Tigertay0/robotics/blender/out/anim_30s.png

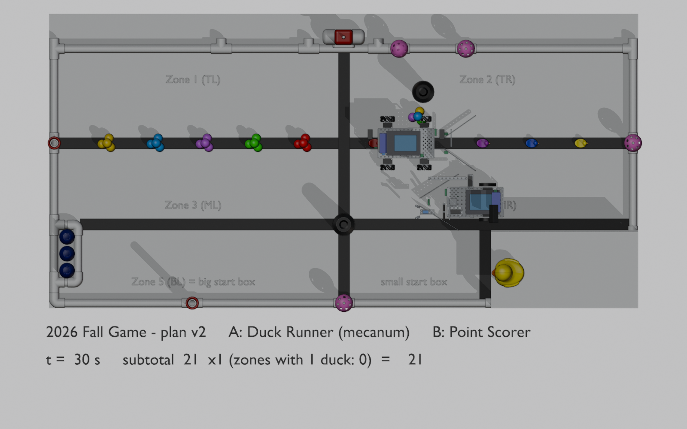
blender/out/anim_30s.png
