Tigertay0/robotics/blender/out/anim_57s.png

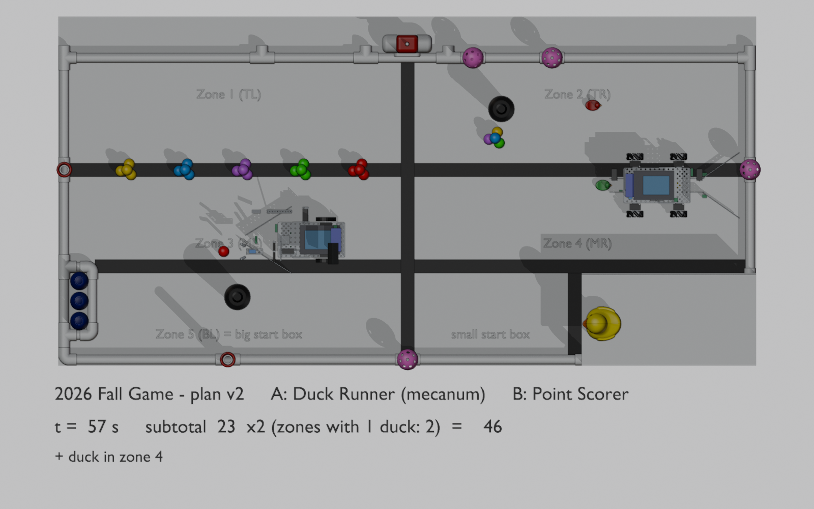
blender/out/anim_57s.png
