Tigertay0/robotics/blender/out/anim_76s.png

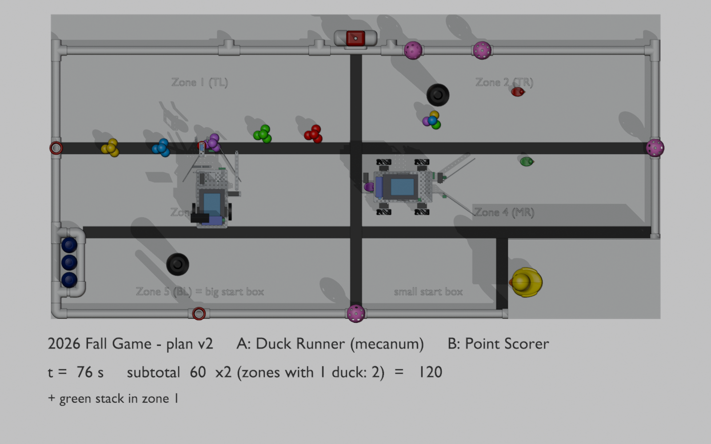
blender/out/anim_76s.png
