Tigertay0/robotics/blender/out/anim_110s.png

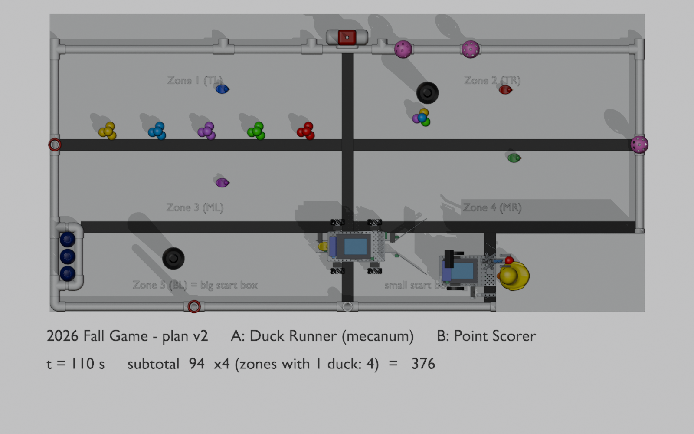
blender/out/anim_110s.png
