Tigertay0/robotics/blender/out/field_iso.png

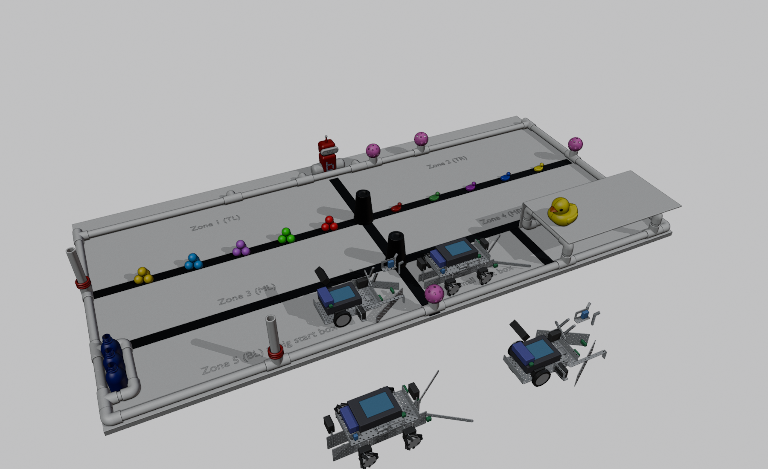
blender/out/field_iso.png
