Tigertay0/robotics/blender/out/field_top.png

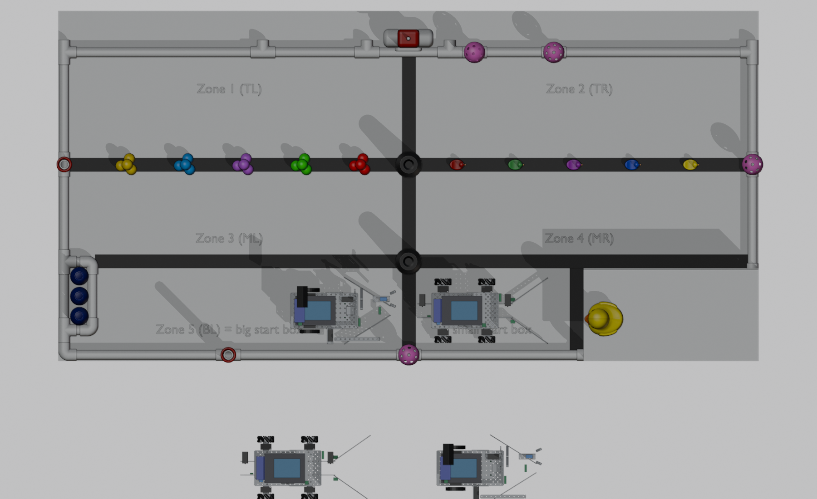
blender/out/field_top.png
