Tigertay0/robotics/blender/out/robot_A.png

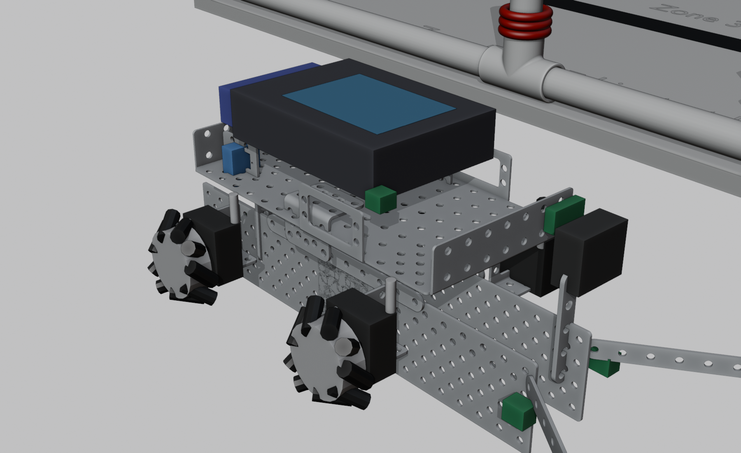
blender/out/robot_A.png
