Tigertay0/robotics/blender/out/robot_A_low.png

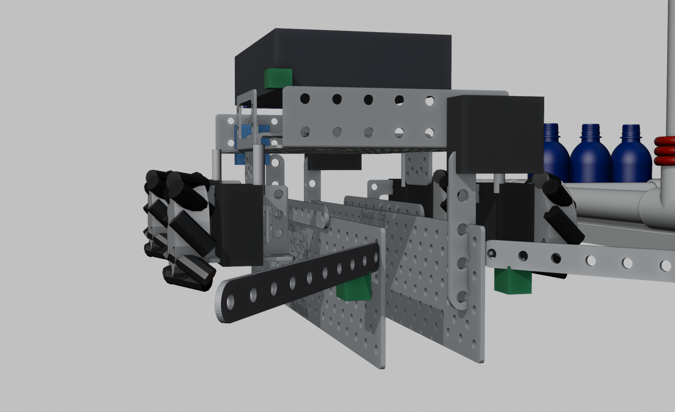
blender/out/robot_A_low.png
