Tigertay0/robotics/blender/out/robot_B.png

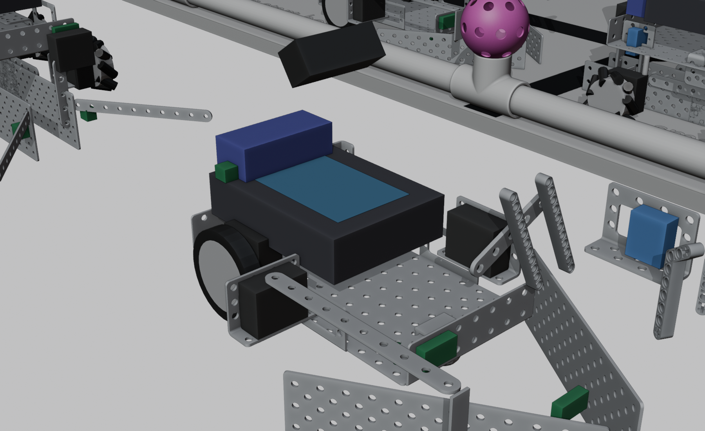
blender/out/robot_B.png
