Tigertay0/robotics/blender/out/start_box.png

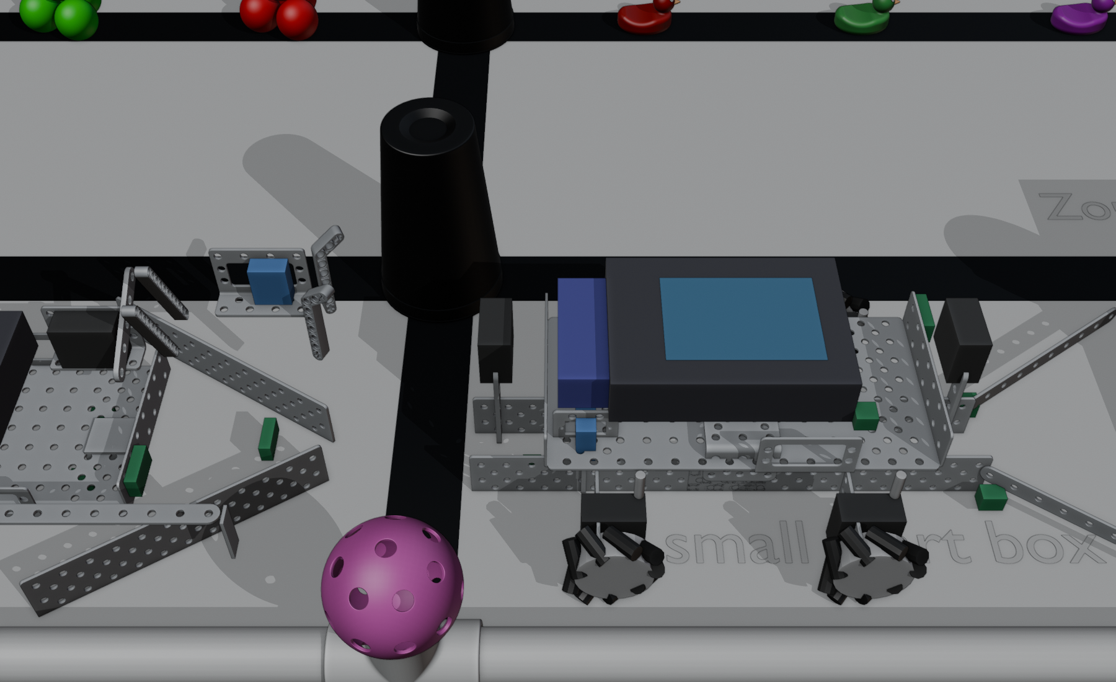
blender/out/start_box.png
