Tigertay0/robotics/docs/official/Fall_Game_Table_Overhead.png

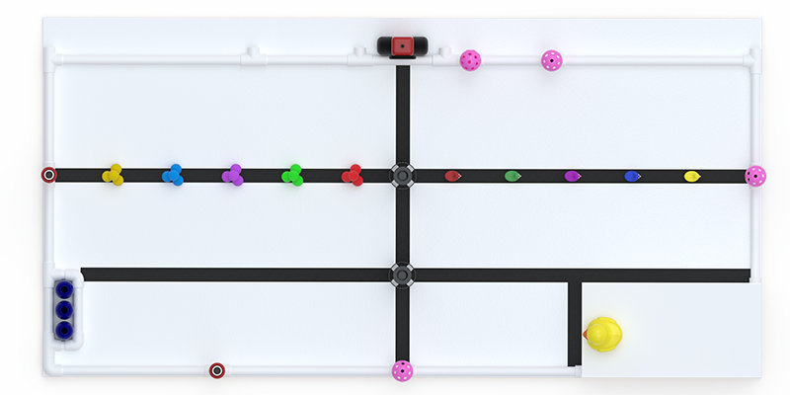
docs/official/Fall_Game_Table_Overhead.png
