Tigertay0/robotics/docs/official/Fall_Game_Zones.jpeg

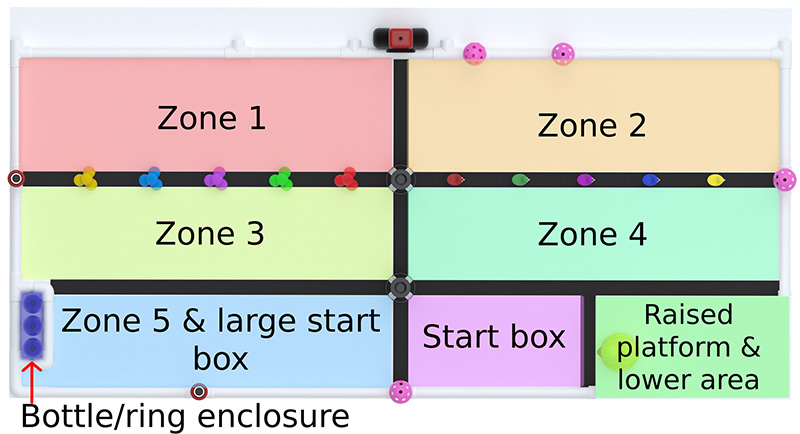
docs/official/Fall_Game_Zones.jpeg
