Tigertay0/robotics/docs/renders/iso.png

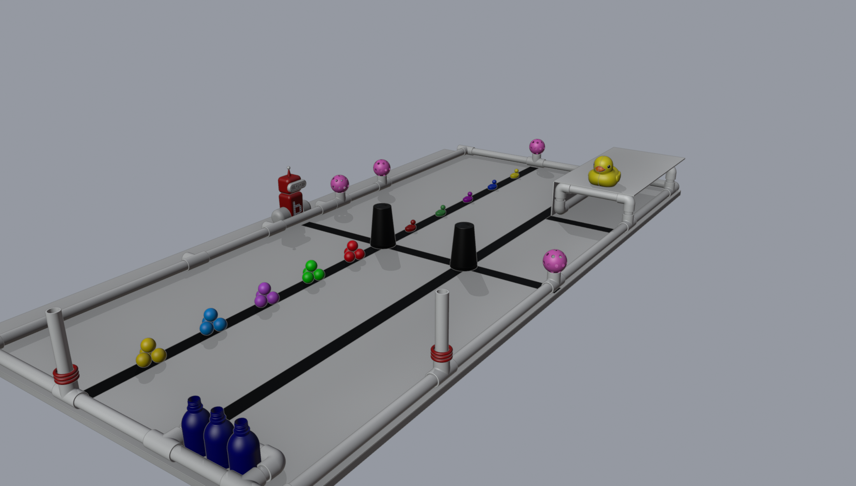
docs/renders/iso.png
