Tigertay0/robotics/docs/renders/platform_front.png

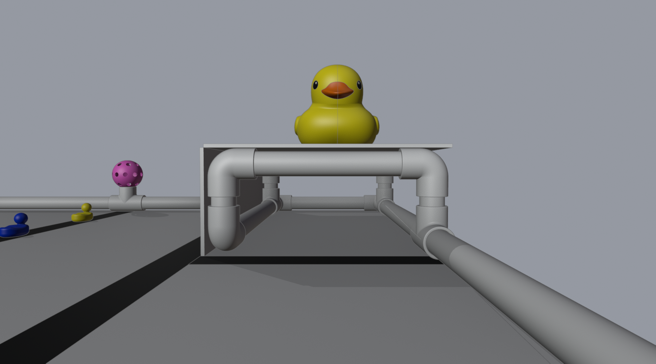
docs/renders/platform_front.png
