Tigertay0/robotics/docs/renders/top_ortho.png

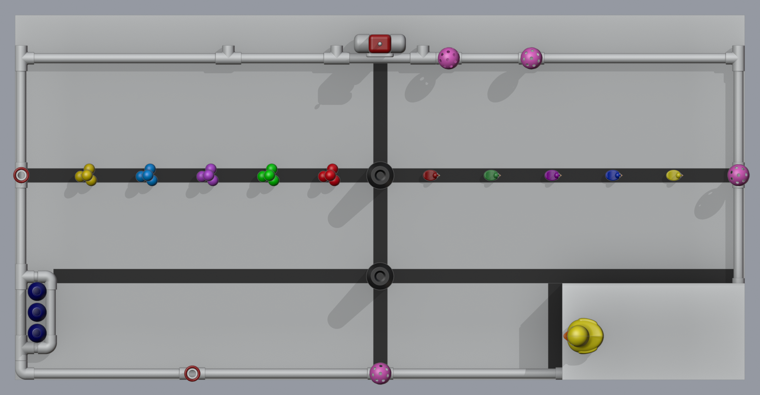
docs/renders/top_ortho.png
