Tigertay0/robotics/parts/team4/p1_chassis_a_top.png

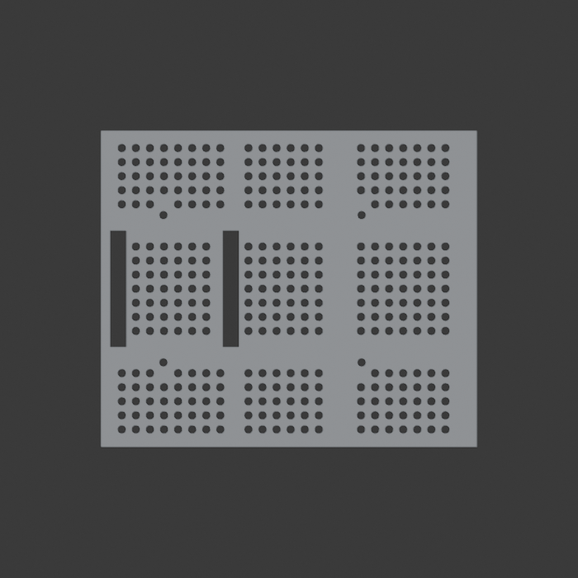
parts/team4/p1_chassis_a_top.png
