Tigertay0/robotics/parts/team4/budget.md

# Print budget check (generated by tools/blender/build_parts.py)

| Slot | Part | Robot | Copies | Class | Size mm | Whole-inch box | Min margin mm | Plastic cm3 | Checks |
|---|---|---|---:|---|---|---|---:|---:|---|
| 1/4 | `p1_chassis_a` | A | 1 | team | 214 x 180 x 59 | 9 x 8 x 3 | 6.0 | 353.68 | pass |
| 2/4 | `p2_claw_jaw` | B | 1 | team | 74 x 105 x 22 | 3 x 5 x 1 | 114.7 | 30.74 | pass |
| 3/4 | `p3_pocket_plow` | B | 1 | team | 108 x 206 x 72 | 5 x 9 x 3 | 13.9 | 107.39 | pass |
| 4/4 | `p4_cup_hook` | B | 1 | team | 157 x 14 x 62 | 7 x 1 x 3 | 63.0 | 20.04 | pass |

Checks = manifold, expected number of bodies, positive volume, fits the size box in mm as exported, >= 1 mm margin. Team rule: 4 parts total, each within 220 x 220 x 250 mm; each print is one solid piece.

Budget used: 4/4 team

Problems: none
