Tigertay0/robotics/docs/manual/bom.md

# Bill of materials vs the 2026 kit (generated by tools/blender/export_build_manual.py)

| Part | Robot A | Robot B | Total | In kit | OK |
|---|---:|---:|---:|---:|---|
| Claw jaw (print 2) | 0 | 1 | 1 | print | yes |
| Cup hook (print 4) | 0 | 1 | 1 | print | yes |
| Pocket plow (print 3) | 0 | 1 | 1 | print | yes |
| Printed chassis (print 1) | 1 | 0 | 1 | print | yes |
| 1 x 11 Liftarm | 0 | 2 | 2 | 10 | yes |
| 1 x 3 Liftarm | 0 | 1 | 1 | 16 | yes |
| 1 x 5 Liftarm | 0 | 1 | 1 | 11 | yes |
| 1 x 5 Servo Horn | 2 | 1 | 3 | 4 | yes |
| 1 x 7 Liftarm | 3 | 1 | 4 | 16 | yes |
| 2-56 1" Caster Screw | 0 | 2 | 2 | 5 | yes |
| 2-56 3/8" Micro Servo Mount Screw | 2 | 0 | 2 | 6 | yes |
| Angle Bracket | 0 | 1 | 1 | 2 | yes |
| Black Camera | 0 | 1 | 1 | 1 | yes |
| Black Gear Motor | 4 | 2 | 6 | 8 | yes |
| Brass Screws | 2 | 2 | 4 | 10 | yes |
| Caster | 0 | 1 | 1 | 2 | yes |
| Channel 3 x 8 | 0 | 1 | 1 | 3 | yes |
| Chassis | 0 | 1 | 1 | 2 | yes |
| ET (Rangefinder) | 1 | 1 | 2 | 2 | yes |
| Lever | 0 | 1 | 1 | 2 | yes |
| Light | 1 | 1 | 2 | 3 | yes |
| M3 x 0.5" x 6" Mecanum Wheel Screw | 4 | 0 | 4 | 6 | yes |
| Mecanum Wheel | 4 | 0 | 4 | 4 | yes |
| Micro Servo | 1 | 0 | 1 | 2 | yes |
| Micro Servo Mount | 1 | 0 | 1 | 2 | yes |
| Nut 8-32 Keps (black) | 49 | 42 | 91 | 170 | yes |
| Pin w/ Friction | 0 | 3 | 3 | 122 | yes |
| Plate 4 x 12 | 2 | 0 | 2 | 4 | yes |
| Round Servo Horn | 0 | 2 | 2 | 2 | yes |
| Screw 8-32 x 1/2" (black) | 45 | 35 | 80 | 90 | yes |
| Screw 8-32 x 1/4" (black) | 12 | 14 | 26 | 40 | yes |
| Screw 8-32 x 3/4" (black) | 0 | 1 | 1 | 70 | yes |
| Servo | 2 | 3 | 5 | 5 | yes |
| Servo Bracket | 2 | 5 | 7 | 8 | yes |
| Short Silver Servo Horn Screw (M3) | 2 | 2 | 4 | 6 | yes |
| Silver Servo Horn Machine Screw (M3) | 0 | 7 | 7 | 10 | yes |
| Silver Servo Horn Nut (M3) | 0 | 6 | 6 | 10 | yes |
| Small Touch | 1 | 0 | 1 | 4 | yes |
| Solarbotics Wheel | 0 | 2 | 2 | 4 | yes |
| Standoff 8-32 x 1" | 4 | 0 | 4 | 7 | yes |
| Standoff 8-32 x 1/2" | 0 | 4 | 4 | 12 | yes |
| Standoff 8-32 x 2" | 2 | 0 | 2 | 2 | yes |
| Strap 1 x 10 | 3 | 0 | 3 | 6 | yes |
| Threaded Rod 8-32 x 1" | 2 | 0 | 2 | 10 | yes |
| Tophat (Reflectance) | 2 | 2 | 4 | 4 | yes |
| Wombat | 1 | 1 | 2 | 2 | yes |
| Wombat Battery | 1 | 1 | 2 | 2 | yes |
| Zip tie 4" (white), structural | 2 | 2 | 4 | 5 | yes |

Printed parts: 4/4

## Size check (start-box limit 11.25 x 21.125 x 12 in = 285.8 x 536.6 x 304.8 mm)

| Robot | Width mm | Length mm | Height mm | Fits |
|---|---:|---:|---:|---|
| A | 271.3 | 400.0 | 160.8 | yes |
| B | 206.1 | 388.1 | 161.6 | yes |

Problems: none
