Tigertay0/robotics/docs/2026 KIPR Metal Parts.pdf

Description | Picture | # in 2026 Kit | Bendable
Strap 1 x 19 | 4 | Yes
Strap 1 x 10 | 6 | Yes
Channel 3 x 8 | 3 | No
Channel 3 x 12 | 2 | No
Channel 3 x 16 | 1 | No
Plate 4 x 12 | 4 | Yes
Chassis | 2 | No

## KIPR Metal

D Bracket | 1 | No
Angle Bracket | 2 | No

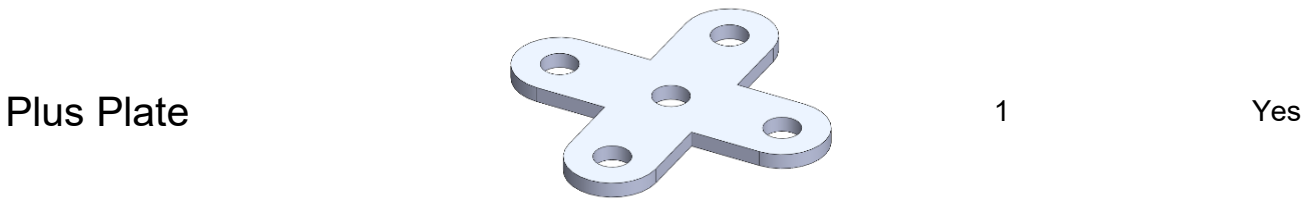
[picture p28: figure]
Plus Plate; Yes

Servo Bracket | 8 | No
Round Servo Horn | 2 | No
1 x 5 Servo Horn | 4 | No

Screw 8-32 x 1/4" (black) | 40
Screw 8-32 x 1/2" (black) | 90
Screw 8-32 x 3/4" (black) | 70
Nut 8-32 Keps (black) | 170
Nut 8-32 Nylock (black) | 30
Standoff 8-32 x 1/2" | 12
Standoff 8-32 x 1" | 7
Standoff 8-32 x 2" | 2

## Screws, Nuts, and Standoffs

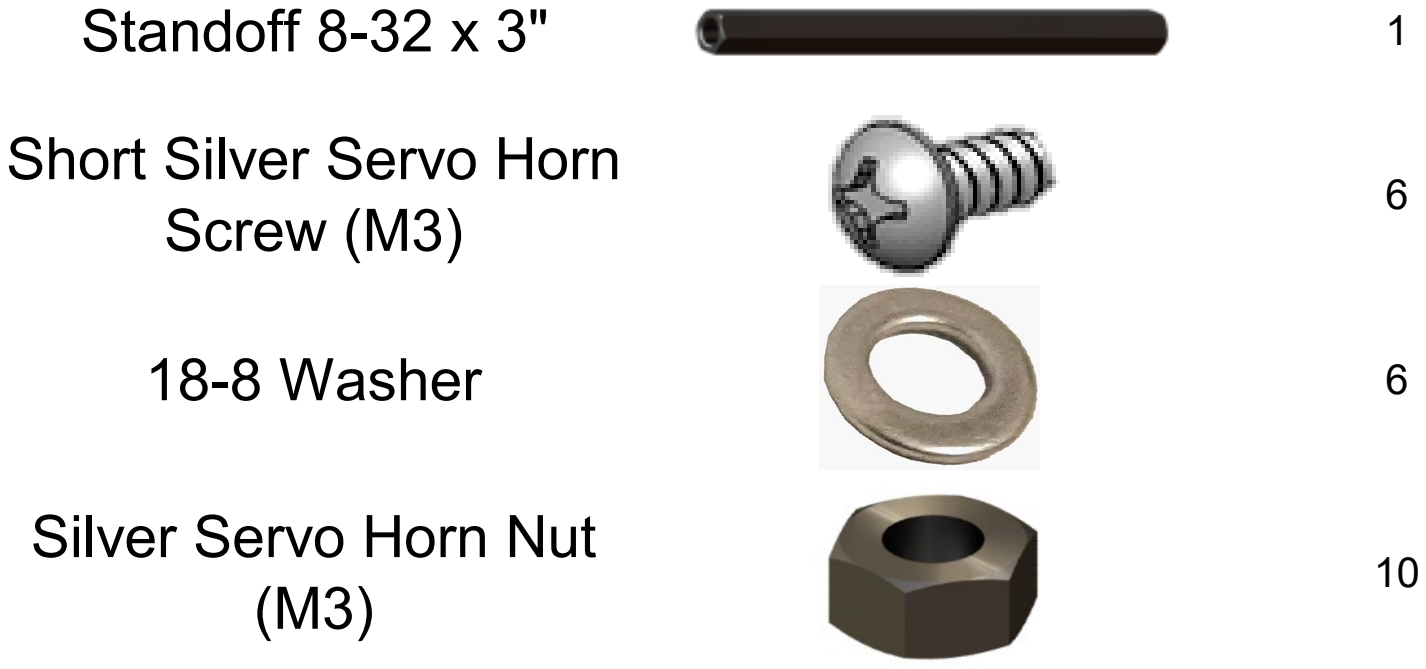
[picture p29: figure]
Standoff 8-32 x 3"; Short Silver Servo Horn; Screw (M3); 18-8 Washer; Silver Servo Horn Nut

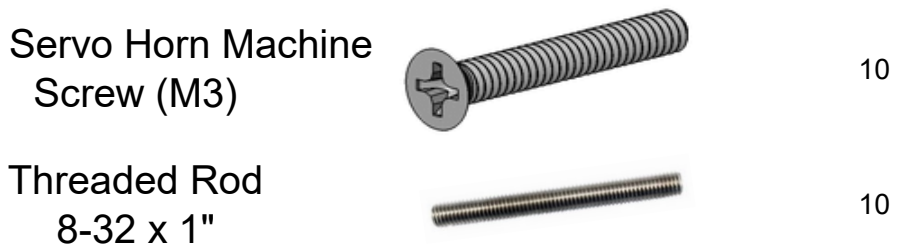
[picture p30: figure]
Screw (M3); Threaded Rod

Silver Servo Horn Machine

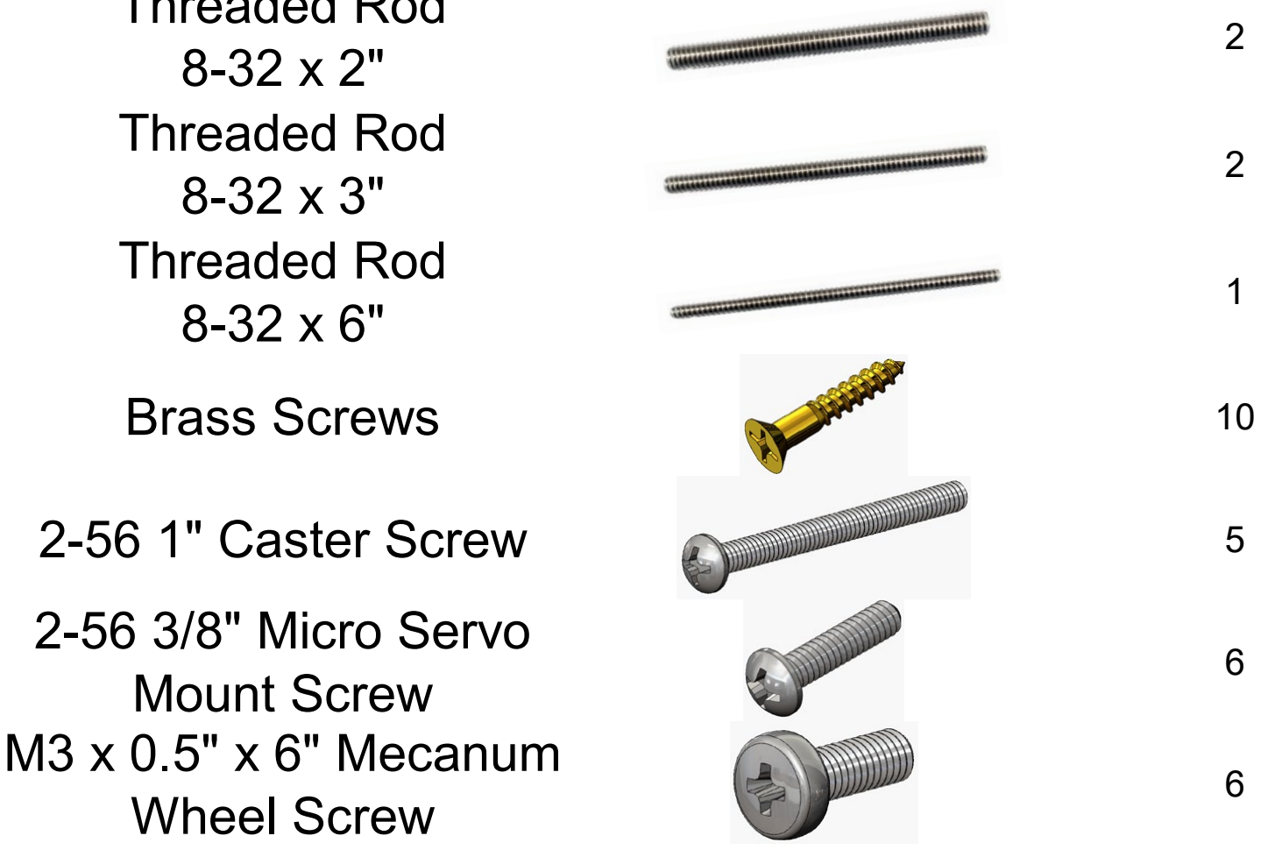
[picture p31: figure]
Threaded Rod; Brass Screws; 2-56 1" Caster Screw; 2-56 3/8" Micro Servo; Mount Screw; M3 x 0.5" x 6" Mecanum; Wheel Screw

Threaded Rod

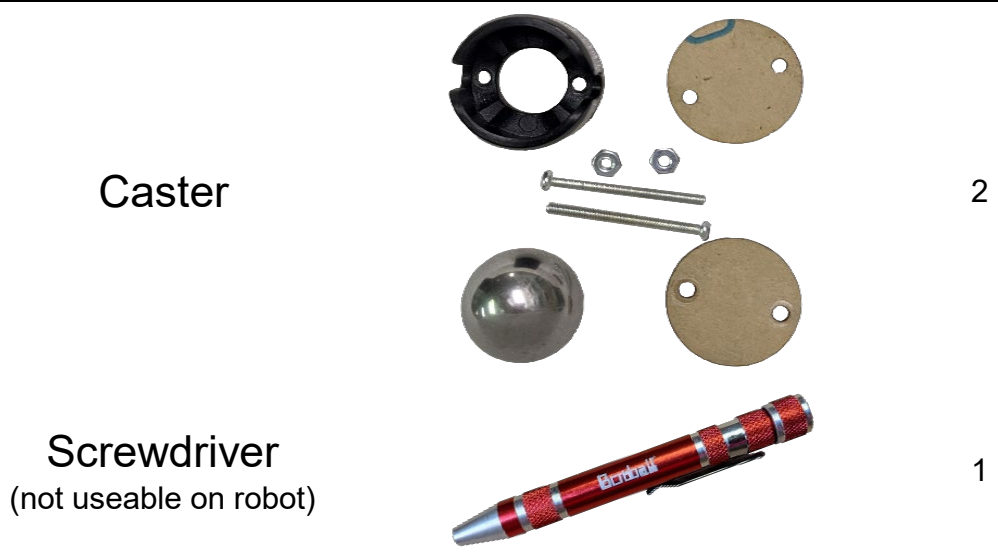
[picture p32: figure]
Caster; Screwdriver (not useable on robot)

11/32" Wrench
(not useable on robot)

1

MISC.
