Tigertay0/robotics/Botball_Fall_Seeding_Scoresheet.xlsx

Theme Budget: $0
A game so good, we forgot the theme.
Team Name: |  |  | Team #:
Round:
Area | Item | Count | Pts Each | Subtotal
1. Base Score | Objects touching board, off black tape | 0 | 1 | 0
2. Pickleballs | Under raised platform | 0 | 7 | 0
3. Rings | Touching bottle, not on neck | 0 | 3 | 0
3. Rings | On bottle neck (volume broken) | 0 | 15 | 0
4. Ducks | Under raised platform | 0 | 3 | 0
5. Cups | Nested in other cup (1=Yes, 0=No) | 0 | 20 | 0
5. Cups | Flat/upright on base each cup (0-2) | 0 | 20 | 0
6. Botguy | On top of raised platform (1=Yes, 0=No) | 0 | 15 | 0
7. Big Duck | At Botguy's starting position (1=Yes, 0=No) | 0 | 15 | 0
8. Mystery Red Pom | Isolated alone on platform (1=Yes, 0=No) | 0 | 50 | 0
9. Pom Zones
Zone (placeholder) | Same-Color Count (0-5) | Unique-Color Count (0-5) |  | Bonus
Zone 1 | 0 | 0 |  | 0
Zone 2 | 0 | 0 |  | 0
Zone 3 | 0 | 0 |  | 0
Zone 4 | 0 | 0 |  | 0
Zone 5 | 0 | 0 |  | 0
Round Subtotal (Areas 1–9) |  |  |  | 0
Overall Multiplier — Zones with Exactly 1 Smaller Duck
Zone | Exactly 1 Duck? (1=Yes, 0=No)
Zone 1 | 0
Zone 2 | 0
Zone 3 | 0
Zone 4 | 0
Zone 5 | 0
Qualifying Zone Count | 0
Multiplier (min 1x, max 5x) | 1
TOTAL SCORE |  |  |  | 0
Legend:
Yellow cells = judge fills in during scoring
Blue text = fixed point value (game constant)
Black text = calculated automatically
