Tigertay0/robotics/parts/team4/p2_claw_jaw_top.png

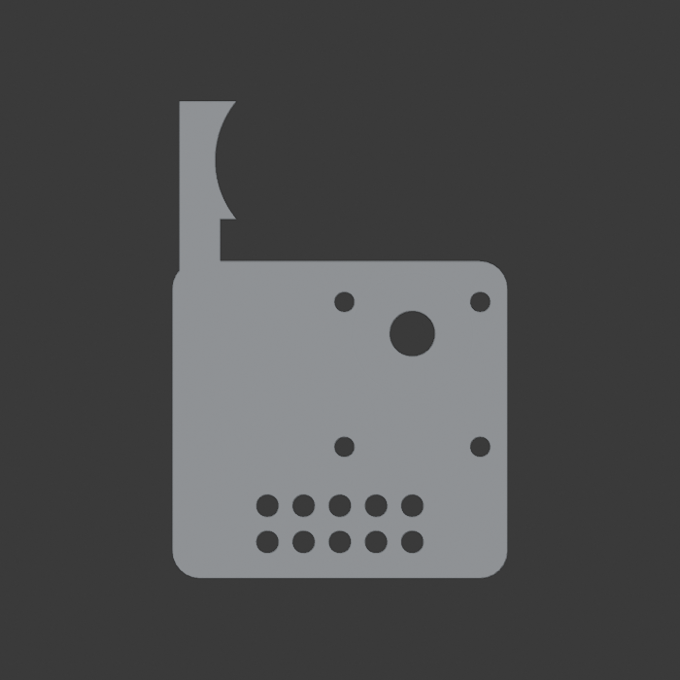
parts/team4/p2_claw_jaw_top.png
