Tigertay0/robotics/parts/team4/p2_claw_jaw_under.png

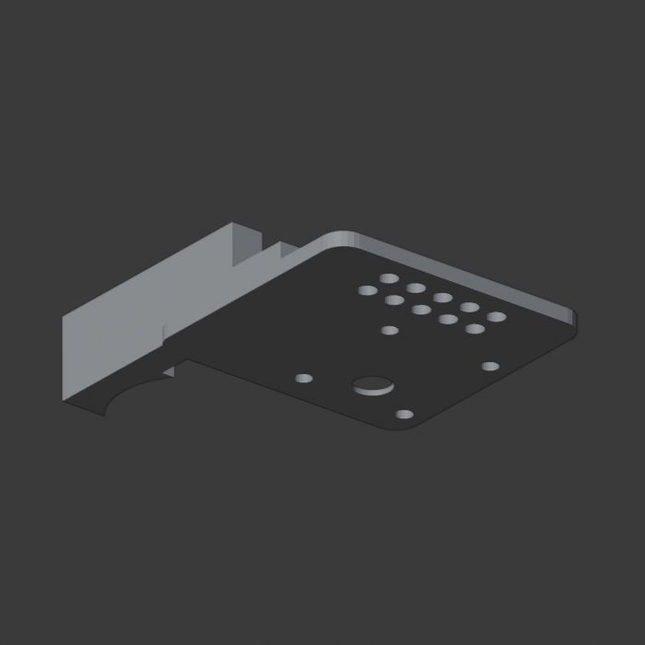
parts/team4/p2_claw_jaw_under.png
