Tigertay0/robotics/parts/team4/p3_pocket_plow.png

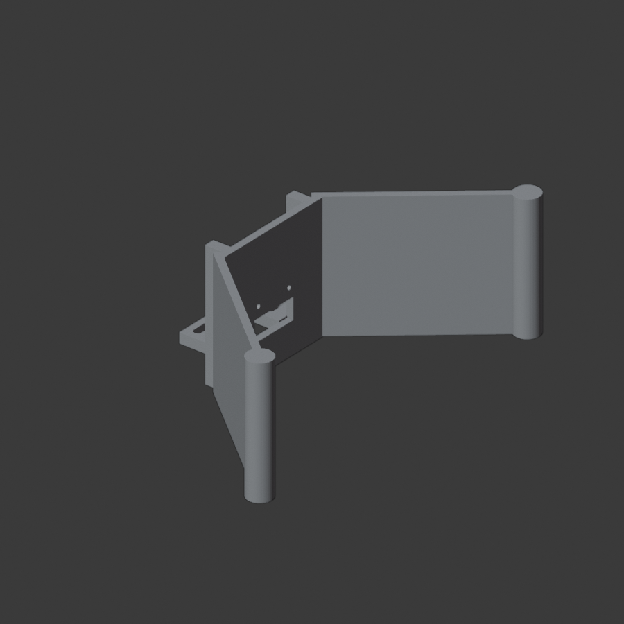
parts/team4/p3_pocket_plow.png
