Tigertay0/robotics/parts/team4/p3_pocket_plow_top.png

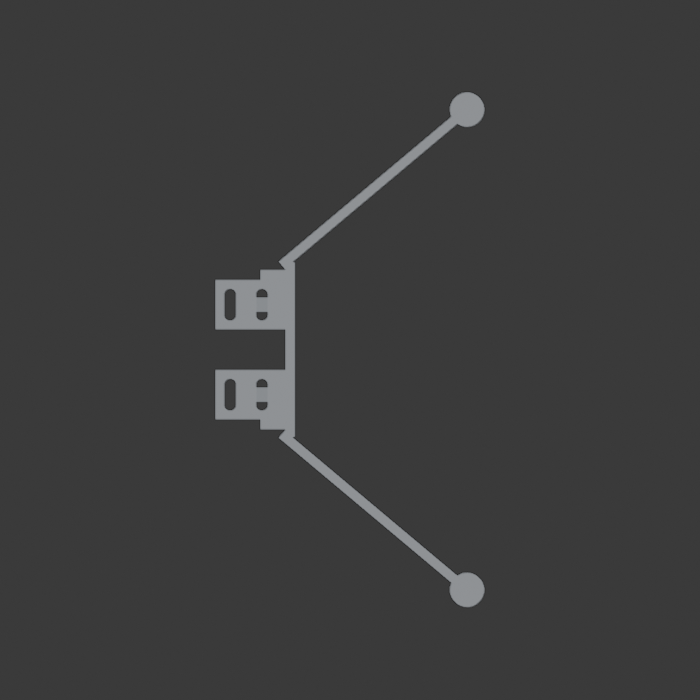
parts/team4/p3_pocket_plow_top.png
