Tigertay0/robotics/parts/team4/p4_cup_hook_top.png

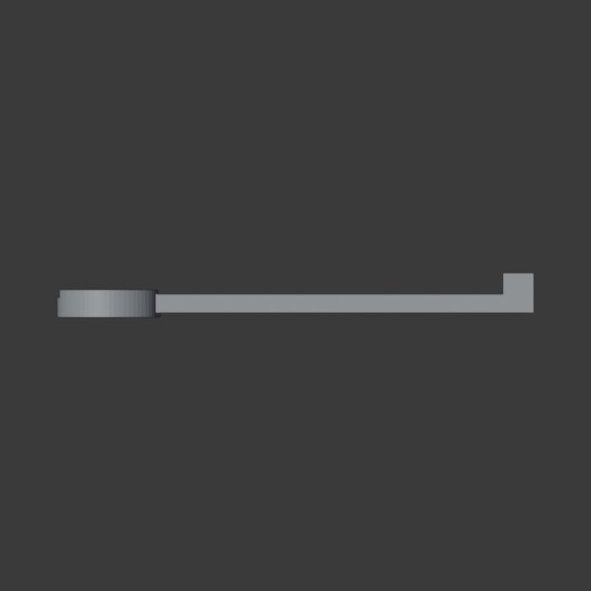
parts/team4/p4_cup_hook_top.png
