Tigertay0/robotics/docs/manual/robot_a.obj

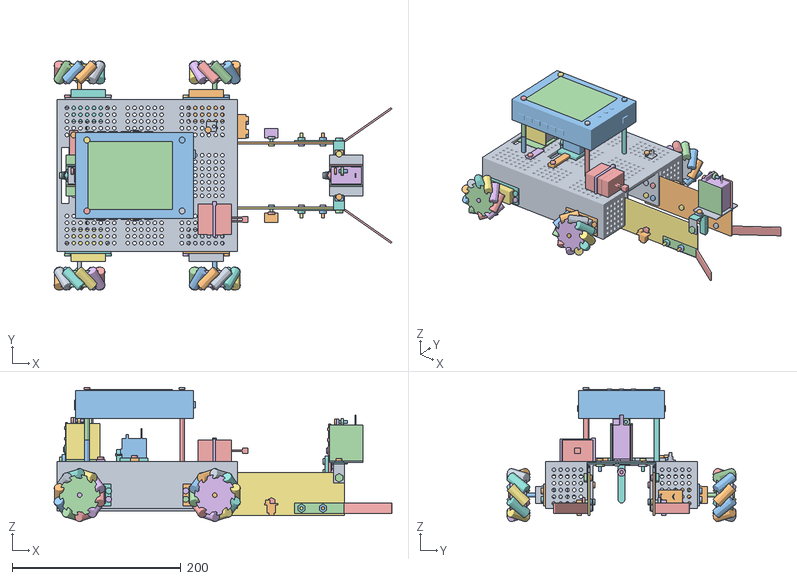
[picture p41: CAD file, 2026-11-10]
docs/manual/robot_a.obj
400.0 x 271.3 x 159.2
01.1|Printed_chassis_(print_1)
02.1|Black_Gear_Motor
02.1|Black_Gear_Motor_(ear)
02.1|Black_Gear_Motor_(shaft)
02.2|Screw_8-32_x_1/2"_(black)
02.2|Screw_8-32_x_1/2"_(black)_(shank)
02.2|Screw_8-32_x_1/2"_(black).001
02.2|Screw_8-32_x_1/2"_(black)_(shank).001
02.2|Screw_8-32_x_1/2"_(black).002
02.2|Screw_8-32_x_1/2"_(black)_(shank).002
02.2|Screw_8-32_x_1/2"_(black).003
02.2|Screw_8-32_x_1/2"_(black)_(shank).003
02.3|Nut_8-32_Keps_(black)
02.3|Nut_8-32_Keps_(black).001
02.3|Nut_8-32_Keps_(black).002
02.3|Nut_8-32_Keps_(black).003
02.4|Black_Gear_Motor
02.4|Black_Gear_Motor_(ear)
02.4|Black_Gear_Motor_(shaft)
02.4|Screw_8-32_x_1/2"_(black)
02.4|Screw_8-32_x_1/2"_(black)_(shank)
02.4|Screw_8-32_x_1/2"_(black).001
02.4|Screw_8-32_x_1/2"_(black)_(shank).001
02.4|Screw_8-32_x_1/2"_(black).002
02.4|Screw_8-32_x_1/2"_(black)_(shank).002
02.4|Screw_8-32_x_1/2"_(black).003
02.4|Screw_8-32_x_1/2"_(black)_(shank).003
02.4|Nut_8-32_Keps_(black)
02.4|Nut_8-32_Keps_(black).001
02.4|Nut_8-32_Keps_(black).002
02.4|Nut_8-32_Keps_(black).003
02.4|Black_Gear_Motor.001
02.4|Black_Gear_Motor_(ear).001
02.4|Black_Gear_Motor_(shaft).001
02.4|Screw_8-32_x_1/2"_(black).004
02.4|Screw_8-32_x_1/2"_(black)_(shank).004
02.4|Screw_8-32_x_1/2"_(black).005
02.4|Screw_8-32_x_1/2"_(black)_(shank).005
02.4|Screw_8-32_x_1/2"_(black).006
02.4|Screw_8-32_x_1/2"_(black)_(shank).006
02.4|Screw_8-32_x_1/2"_(black).007
02.4|Screw_8-32_x_1/2"_(black)_(shank).007
02.4|Nut_8-32_Keps_(black).004
02.4|Nut_8-32_Keps_(black).005
02.4|Nut_8-32_Keps_(black).006
02.4|Nut_8-32_Keps_(black).007
02.4|Black_Gear_Motor.002
02.4|Black_Gear_Motor_(ear).002
02.4|Black_Gear_Motor_(shaft).002
02.4|Screw_8-32_x_1/2"_(black).008
02.4|Screw_8-32_x_1/2"_(black)_(shank).008
02.4|Screw_8-32_x_1/2"_(black).009
02.4|Screw_8-32_x_1/2"_(black)_(shank).009
02.4|Screw_8-32_x_1/2"_(black).010
02.4|Screw_8-32_x_1/2"_(black)_(shank).010
02.4|Screw_8-32_x_1/2"_(black).011
02.4|Screw_8-32_x_1/2"_(black)_(shank).011
02.4|Nut_8-32_Keps_(black).008
02.4|Nut_8-32_Keps_(black).009
02.4|Nut_8-32_Keps_(black).010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
