Tigertay0/robotics/parts/team4/p2_claw_jaw.stl

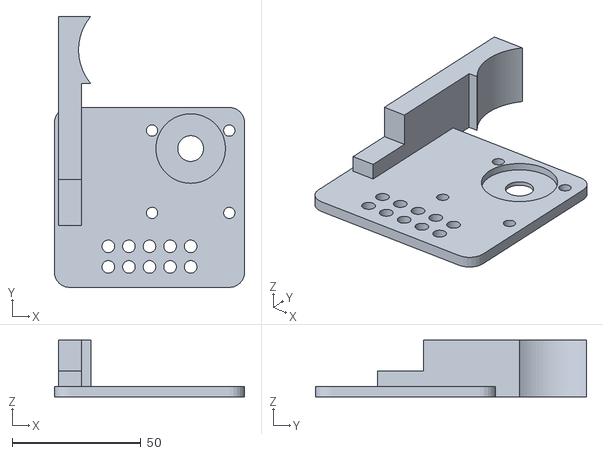
[picture p42: CAD file, 2026-11-10]
parts/team4/p2_claw_jaw.stl
74.0 x 105.3 x 22.0
