Tigertay0/robotics/prints/out/lane_front.stl

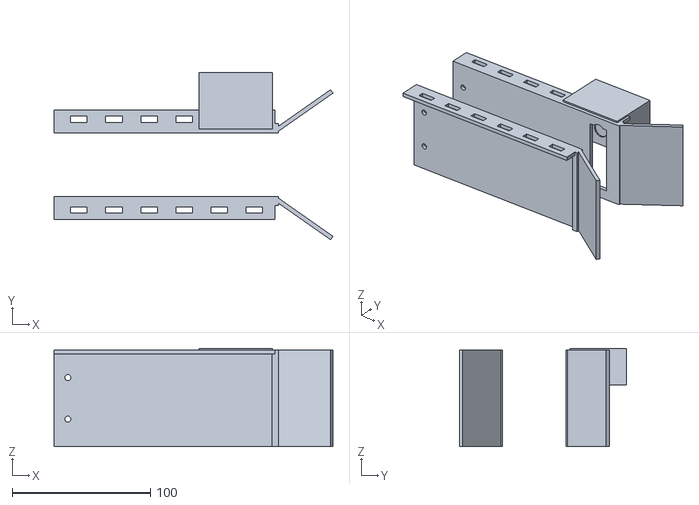
[picture p43: CAD file, 2026-10-21]
prints/out/lane_front.stl
201.8 x 121.1 x 71.2
