Tigertay0/robotics/docs/manual/robot_b.obj

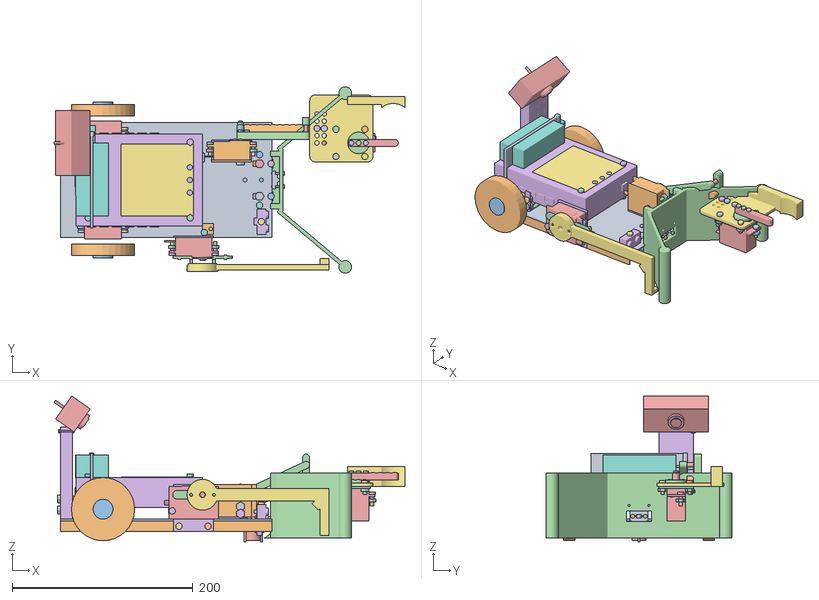
[picture p44: CAD file, 2026-11-10]
docs/manual/robot_b.obj
388.1 x 206.1 x 161.4
01.1|Chassis
01.1|Chassis_(flange)
01.1|Chassis_(flange).001
02.1|Servo_Bracket
02.1|Servo_Bracket.001
02.1|Servo_Bracket.002
02.1|Screw_8-32_x_1/4"_(black)
02.1|Screw_8-32_x_1/4"_(black)_(shank)
02.1|Nut_8-32_Keps_(black)
02.1|Screw_8-32_x_1/4"_(black).001
02.1|Screw_8-32_x_1/4"_(black)_(shank).001
02.1|Nut_8-32_Keps_(black).001
02.2|Black_Gear_Motor
02.3|Screw_8-32_x_1/2"_(black)
02.3|Screw_8-32_x_1/2"_(black)_(shank)
02.3|Nut_8-32_Keps_(black)
02.3|Screw_8-32_x_1/2"_(black).001
02.3|Screw_8-32_x_1/2"_(black)_(shank).001
02.3|Nut_8-32_Keps_(black).001
02.3|Screw_8-32_x_1/2"_(black).002
02.3|Screw_8-32_x_1/2"_(black)_(shank).002
02.3|Nut_8-32_Keps_(black).002
02.3|Screw_8-32_x_1/2"_(black).003
02.3|Screw_8-32_x_1/2"_(black)_(shank).003
02.3|Nut_8-32_Keps_(black).003
02.4|Solarbotics_Wheel
02.4|Solarbotics_Wheel_(hub)
02.5|Servo_Bracket
02.5|Servo_Bracket.001
02.5|Servo_Bracket.002
02.5|Screw_8-32_x_1/4"_(black)
02.5|Screw_8-32_x_1/4"_(black)_(shank)
02.5|Nut_8-32_Keps_(black)
02.5|Screw_8-32_x_1/4"_(black).001
02.5|Screw_8-32_x_1/4"_(black)_(shank).001
02.5|Nut_8-32_Keps_(black).001
02.5|Black_Gear_Motor
02.5|Screw_8-32_x_1/2"_(black)
02.5|Screw_8-32_x_1/2"_(black)_(shank)
02.5|Nut_8-32_Keps_(black).002
02.5|Screw_8-32_x_1/2"_(black).001
02.5|Screw_8-32_x_1/2"_(black)_(shank).001
02.5|Nut_8-32_Keps_(black).003
02.5|Screw_8-32_x_1/2"_(black).002
02.5|Screw_8-32_x_1/2"_(black)_(shank).002
02.5|Nut_8-32_Keps_(black).004
02.5|Screw_8-32_x_1/2"_(black).003
02.5|Screw_8-32_x_1/2"_(black)_(shank).003
02.5|Nut_8-32_Keps_(black).005
02.5|Solarbotics_Wheel
02.5|Solarbotics_Wheel_(hub)
02.6|Caster
02.6|Caster_(ball)
02.6|2-56_1"_Caster_Screw
02.6|2-56_1"_Caster_Screw_(shank)
02.6|2-56_1"_Caster_Screw.001
02.6|2-56_1"_Caster_Screw_(shank).001
03.1|Standoff_8-32_x_1/2"
03.1|Screw_8-32_x_1/4"_(black)
03.1|Screw_8-32_x_1/4"_(black)_(shank)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
