Tigertay0/robotics/parts/team4/p1_chassis_a.stl

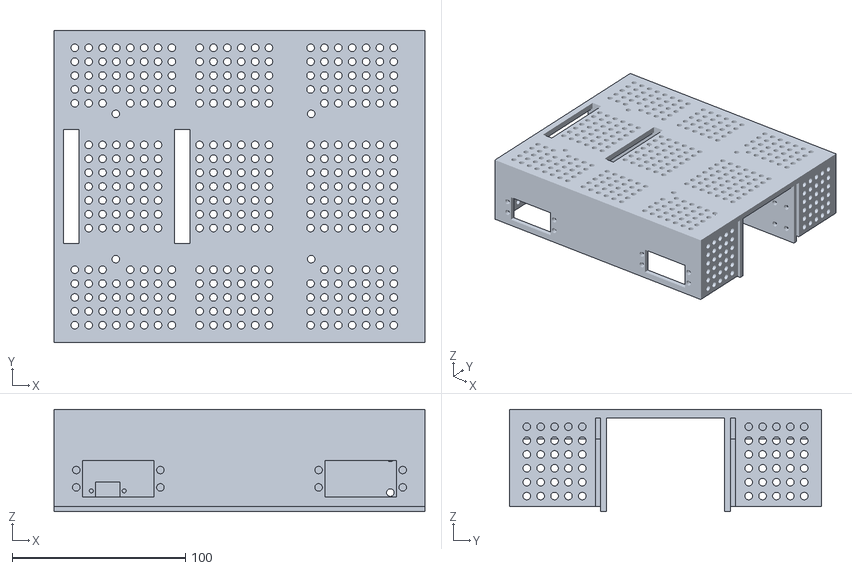
[picture p45: CAD file, 2026-11-10]
parts/team4/p1_chassis_a.stl
214.0 x 180.0 x 59.0
