Tigertay0/robotics/prints/out/lane_rear.stl

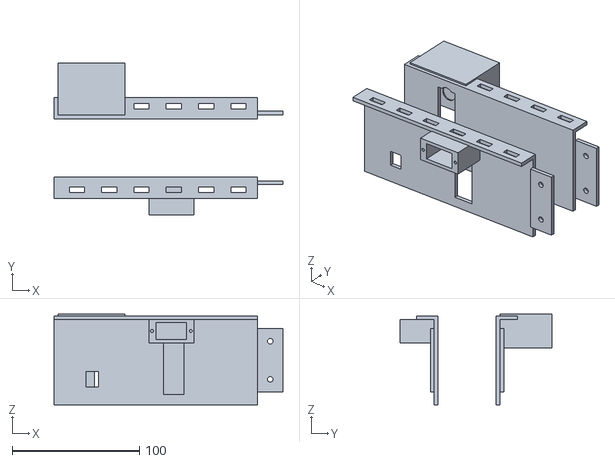
[picture p46: CAD file, 2026-10-21]
prints/out/lane_rear.stl
180.0 x 119.7 x 71.2
