Tigertay0/robotics/parts/team4/p4_cup_hook.stl

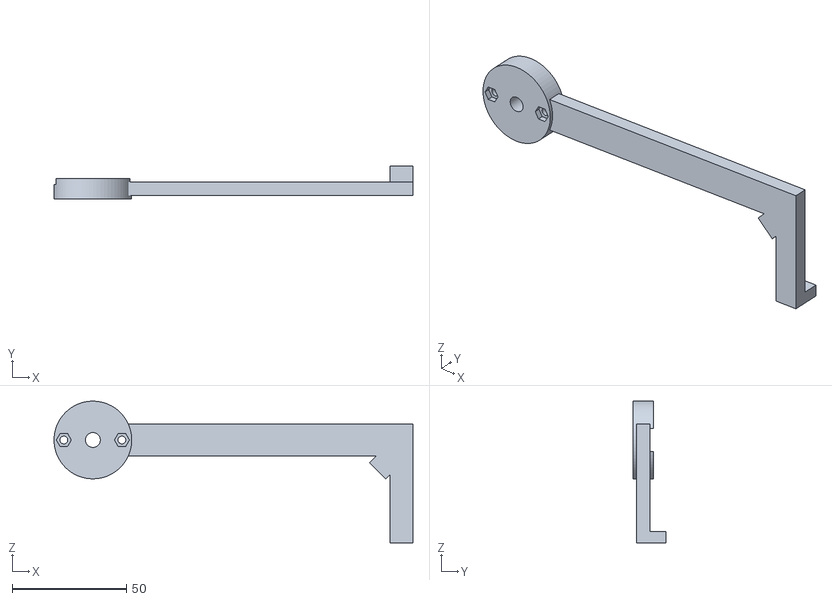
[picture p47: CAD file, 2026-11-10]
parts/team4/p4_cup_hook.stl
157.0 x 14.5 x 62.0
