Tigertay0/robotics/parts/team4/p3_pocket_plow.stl

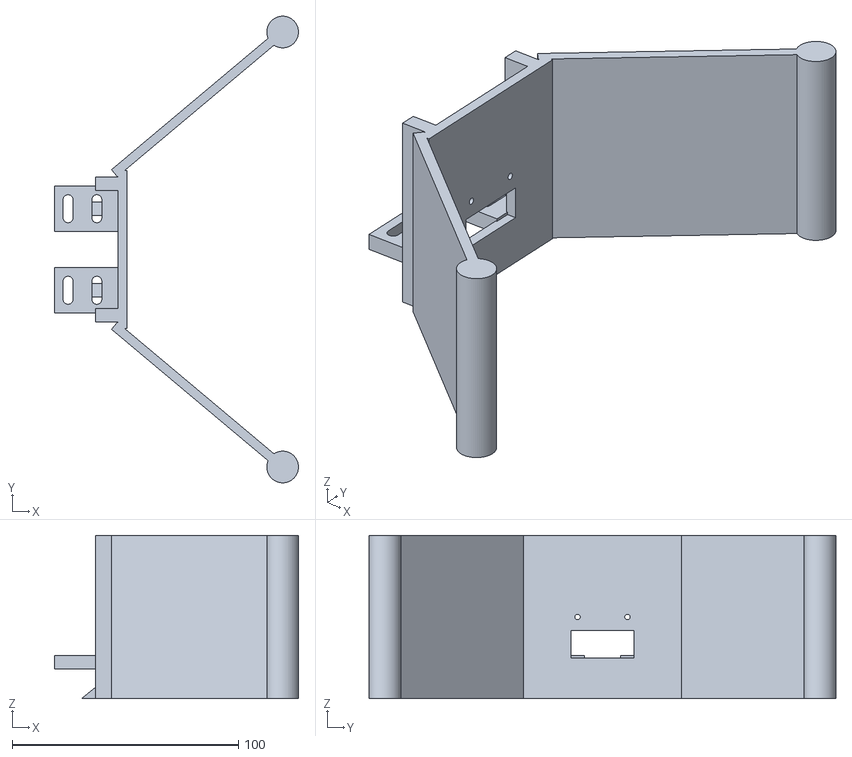
[picture p48: CAD file, 2026-11-10]
parts/team4/p3_pocket_plow.stl
107.8 x 206.1 x 72.0
