Tigertay0/robotics/(list of files, cad)

Other CAD files:
blender/out/fall_game_2026.blend
blender/out/fall_game_2026_animated.blend
parts/team4/p1_chassis_a.obj
parts/team4/p2_claw_jaw.obj
parts/team4/p3_pocket_plow.obj
parts/team4/p4_cup_hook.obj
