Tigertay0/robotics/3D_PRINTS.md

# 3D-printed parts: the 4 we print

**Team rule (Nov 3, 2026): 4 printed parts in total, any size** up to the printer bed (Ender 3 V3 SE: 220 × 220 × 250 mm). **Each print is one solid piece** (Nov 10, 2026: the claw may not be three bodies printed together, so it was redesigned). This replaces the 6 small / 2 mid / 1 large classes in the rule summary. PLA or PETG, grey only, and the STL of every part is submitted before the tournament.

All four are generated by Blender scripts and checked automatically:

```bash
python tools/blender/build_parts.py
```

That writes `parts/team4/<part>.stl` and the same mesh as `<part>.obj` (both millimetres, Z up, slicer-ready), previews, and [parts/team4/budget.md](parts/team4/budget.md). The build fails if a part doesn't fit the bed, isn't watertight, has the wrong number of bodies, or if the plan goes over 4 parts. **Every size in the scripts comes from the CAD model, not real pieces:** measure ducks, pom, cup rim, servos and horns, edit the `MEASURE` constants at the top of each script, and re-run before printing.

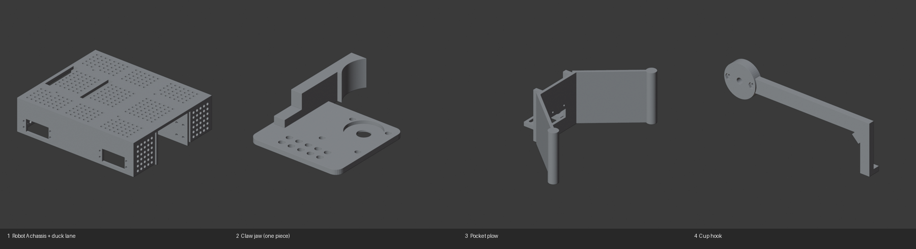
[picture p49: parts/team4/contact_sheet.png]
the 4 prints


| # | Part | Robot | Size (mm) | What it does | Points it protects (×5) |
|---|---|---|---|---|---|
| 1 | **Robot A chassis with built-in duck lane** `p1_chassis_a` | A | 214 × 180 × 59 | Replaces the metal chassis, standoffs, motor brackets and the rear of the metal lane. Sized for the **measured duck: 60 × 60 mm, 53 mm tall**. The channel is **68 mm wide**; the deck underside is 65 mm above the floor on 60 mm wheels (12 mm over a duck); the channel walls stop **11 mm above the floor**. The motor (wheel) holes are **7 mm lower** in the part than before and **8 mm closer to the middle** (axles at ±80 mm), so the outer ear screws are clear of the end walls. Exit gate A slot and pin gate B slot (64 mm apart: one duck + the flap); a slot beside each lane wall at the front for the kit intake plate; lane switch window; Wombat hole pattern; **452 accessory holes** (4.4 mm on an 8 mm grid). Robot width with wheels ≈ 272 mm, inside the 11.25" (286 mm) start box. | The multiplier: a double drop costs a whole zone |
| 2 | **Claw jaw** `p2_claw_jaw` | B | 74 × 105 × 22 | **One solid piece**: a base plate with a fixed finger and a curved pad for the 1.6" red pom. The moving finger is **not printed**: a kit 1×7 liftarm bolted on a Round Servo Horn, turned by a kit Servo in a Servo Bracket under the base (shaft up through the base). Closed, the gap is 38.6 mm, 2 mm less than the pom, so it is squeezed. | Red pom alone on the platform: 255 |
| 3 | **Pocket plow** `p3_pocket_plow` | B | 108 × 206 × 72 | One piece instead of two bent plates: flat centre face plus forward wings, so a pushed pom stack stays in the pocket as one group. Rounded tips, a lever-switch pocket, and slotted mounting tabs. | 5 pom groups in zone 1: 200; pickleball: 40 |
| 4 | **Cup hook** `p4_cup_hook` | B | 157 × 13 × 62 | Stiff arm on the hook servo's horn. Its tip drops 1.5" and ends in an inward lip that catches the cup rim while the plow wing rolls the cup upright. | Both cups upright: 210 |

**Not printed:**
- **The front 4" of the duck lane, the intake funnel and intake gate C:** kit metal (two 4×12 plates and two flared 1×10 straps), bolted to the lane wall ends at the front of print 1 (holes provided). The full lane is 12.5" (317 mm), longer than the 214 mm chassis and the bed. The 5 ducks need it all.
- **The ring fork:** dropped, because nothing on the robots can lift it 9".
- **The moving claw finger:** a kit 1×7 liftarm on a servo horn (see print 2).
- **Claw pads, plow end caps and the flap pad:** they were separate prints and are now built into prints 2 and 3.

### Order and settings

1. **Print 1 first** (≈ 354 cm³ of PLA, a long print: ~18–24 h at 0.2 mm). It carries the whole duck robot and the escapement, the only mechanism that touches the multiplier. Bench target: 50 drops in a row with no double drop. **Measure the motor and its ears first**: the motor windows and ear holes are estimates from the Blender model.
2. Then print 2 (≈ 31 cm³, short) and print 4. Print 3 last, and only after checking that the cup flips (Robot B's first 16 s) still work with the pocket shape: the metal V had its point forward.
3. Grey PLA, 0.2 mm layers, 3 walls, 20% infill, no supports.
   - Print 1 deck-down (upside down), no supports: the walls grow upward and the motor windows bridge 21 mm. It is 59 mm tall. 214 mm on a 220 mm bed leaves 3 mm per side: no brim.
   - Print 2 flat, base on the bed. No supports: the finger and pad are vertical walls.
   - Print 3 standing up.
   - Print 4 on its side.
4. Export and submit the 4 STLs from `parts/team4/` on the Team Home Base schedule.

### History

The first version of this file ranked 9 parts for the old class rule: a duck lane in 2 halves, claw pads ×2, cup hook, plow end caps ×2, flap pad and the ring fork. Those designs and the KIPR example STLs were deleted from the repo because we print only these 4 (they remain in the git history).

### Changes on Nov 10, 2026 (after the first test print)

- **Ducks measured: 60 × 60 × 53 mm** (the game documents said 58 × 37 × 37). The old channel (45.7 mm wide, 46 mm high) was too small: ducks did not go through.
- Chassis: channel 68 mm wide; deck 12 mm higher over the lane; motor holes 7 mm lower and 8 mm closer to the middle; pin-gate slot now 64 mm in front of the exit slot (one duck + the flap); front slots for the intake plates.
- Claw: one solid jaw instead of three print-in-place bodies. The old geared design is in the git history (`p2_geared_claw`).
- Every part is also exported as OBJ. The whole robots are in `docs/manual/robot_a.obj` and `robot_b.obj` (one object per part).
- Both robots are checked against the start-box limit when the manual is exported: see the size table in [docs/manual/bom.md](docs/manual/bom.md).
