Tigertay0/robotics/guide/index.html

# Rochambotics Build Guide

Both robots for the 2026 Fall Game, built only from the 2026 kit. Click a step to see those parts appear on the model; drag to orbit, scroll to zoom.

Robot A · Duck Runner Robot B · Point Scorer

loading model…

drag · scroll · right-drag to pan

added in this stepalready built

Step 1

Previous Next step Show finished robot

## Do 3D-printed parts help?

The rules allow PLA or PETG prints in grey only: 6 small parts (60 × 60 × 20 mm), 2 mid-size (220 × 220 × 80 mm) and 1 large (220 × 220 × 250 mm), with every STL submitted before the tournament. Prints don't score by themselves. They matter where a part's shape decides whether a high-value item works. Ranked by the points they protect:

Print | Size class | Replaces | Why | Points at stake (×5)
Duck lane, two 160 mm halves | 2 mid-size | 4 plates, 2 straps, 2 angle brackets, funnel straps | Exact 1.8" channel, no bolt heads inside, funnel and flap mounts built in. Every jam or double drop costs a multiplier step. | the ×5 itself
Claw pads shaped for a 1.6" pom | 2 small | bare liftarm fingers | A pom slips out of flat fingers; the red pom is grabbed once and is worth 250. | 255
Cup hook with a lip for the 5.1" rim | 1 small | bent 1×10 strap | Catches the rim at any approach angle. | 210
Plow end caps | 2 small | bare plate edges | Keeps a pushed pom stack together as one group (8 pts) instead of splitting it. | 200
Flap pad for the intake gate | 1 small | bare servo horn | Wider flap face so no duck squeezes past. | part of the lane
Ring fork, 200 mm | 1 large | nothing exists yet | Lifts a stack of 3 rings off a post to drop over a bottle neck (15 each, tiebreaker #1). Needs a ~9" lift the servo arm can't give: a new mechanism, not just a print. | up to 480

Order: print the lane first (it is the only print that touches the multiplier), then the claw pads and the cup hook. Leave the ring fork until the core plan scores 500+ three times in a row. Full write-up in 3D_PRINTS.md.
