Tigertay0/robotics/prints/out/lane_render.png

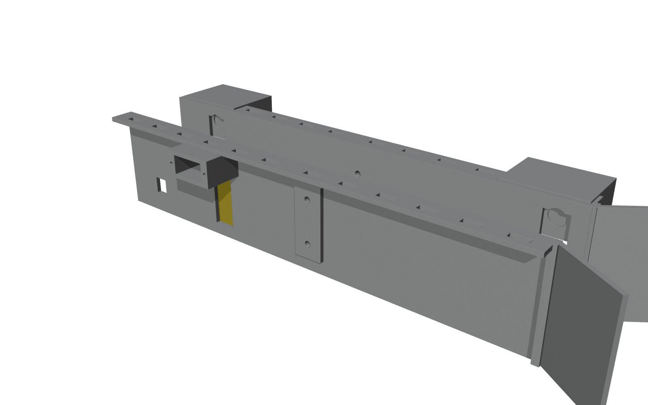
prints/out/lane_render.png
