Tigertay0/robotics/prints/out/lane_top.png

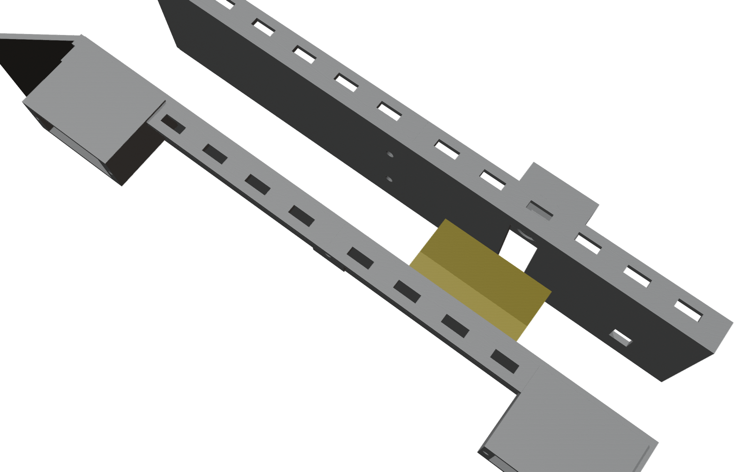
prints/out/lane_top.png
