Tigertay0/robotics/docs/animation/plan_debug.png

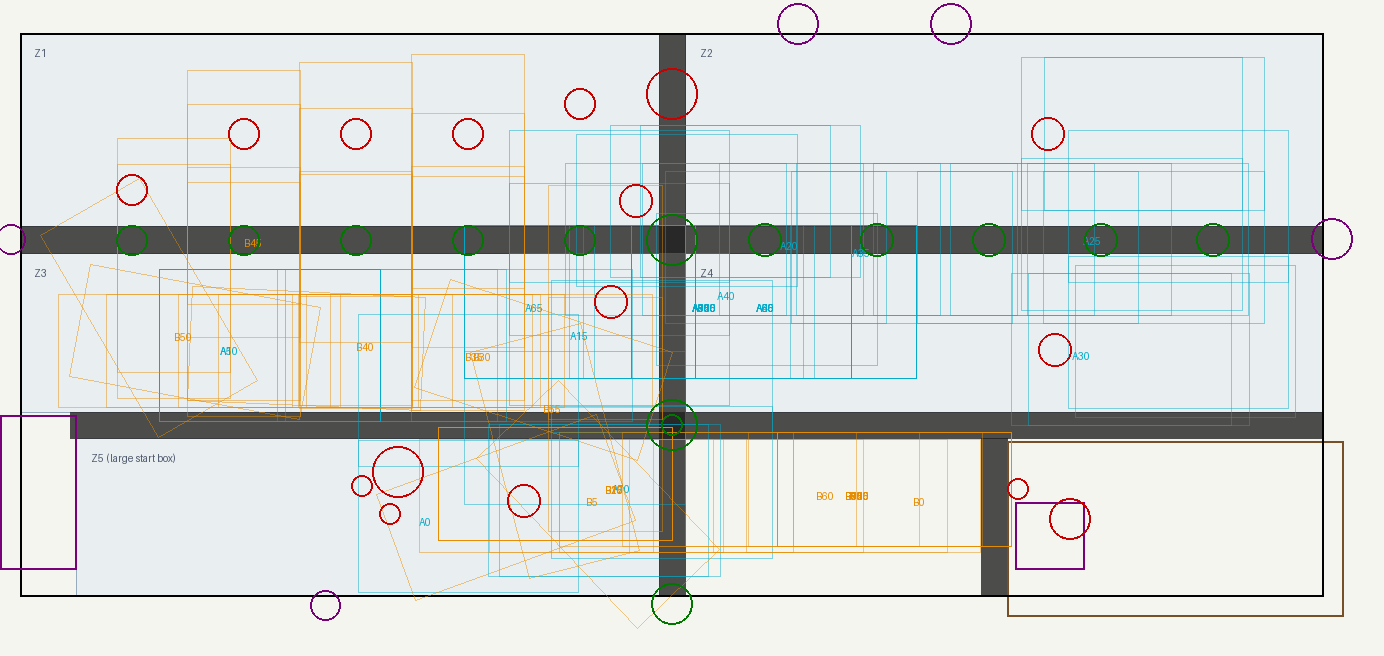
docs/animation/plan_debug.png
