Tigertay0/robotics/Fall_Game_Table.pdf

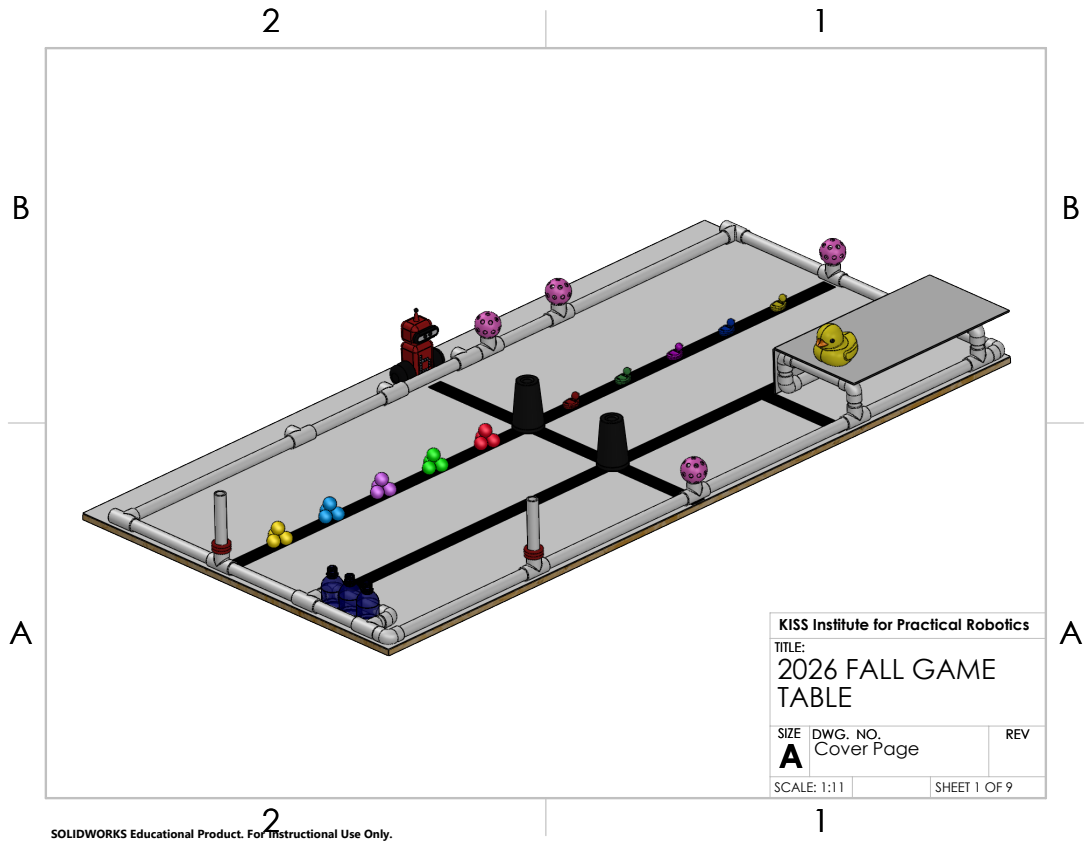
[picture p53: page 1]

KISS Institute for Practical Robotics
TITLE:
2026 FALL GAME
TABLE

SIZE SIZE A A | DWG. NO. DWG. NO. Cover Page | REV

SCALE: 1:11 | | SHEET 1 OF 9

SOLIDWORKS Educational Product. For Instructional Use Only.

# Fall Game Table BOM

ITEM NO. | PART NUMBER | DESCRIPTION | QTY.
1 | 1.75 inch pvc | 1" ID SCH 40 | 4
2 | 2.5 inch pvc | 1" ID SCH 40 | 6
3 | 8 inch pvc | 1" ID SCH 40 | 4
4 | 9.5 inch pvc | 1" ID SCH 40 | 4
5 | 10.000 inch PVC | 1" ID SCH 40 | 1
6 | 12.000 inch PVC | 1" ID SCH 40 | 1
7 | 12.875 inch pvc | 1" ID SCH 40 | 1
8 | 13.875 inch pvc | 1" ID SCH 40 | 1
9 | 14 inch pvc | 1" ID SCH 40 | 2
10 | 17.625 inch pvc | 1" ID SCH 40 | 2
11 | 21.125 inch pvc | 1" ID SCH 40 | 1
12 | 23.375 inch pvc | 1" ID SCH 40 | 2
13 | 25.875 inch pvc | 1" ID SCH 40 | 2
14 | Black duct tape | 3M Black Duct Tape - Model #3920-BK | 1
15 | 1" Elbow Connector | Connector SCH 40 | 9
16 | 1" T Connector | Connector SCH 40 | 17
17 | 18"x24" Sheet | Corrugated Plastic | 1
18 | FRP 4' x 8' | White | 1
19 | Particle Board 4' x 8' x 3/8" thick | or similar | 1

A

B

A

B

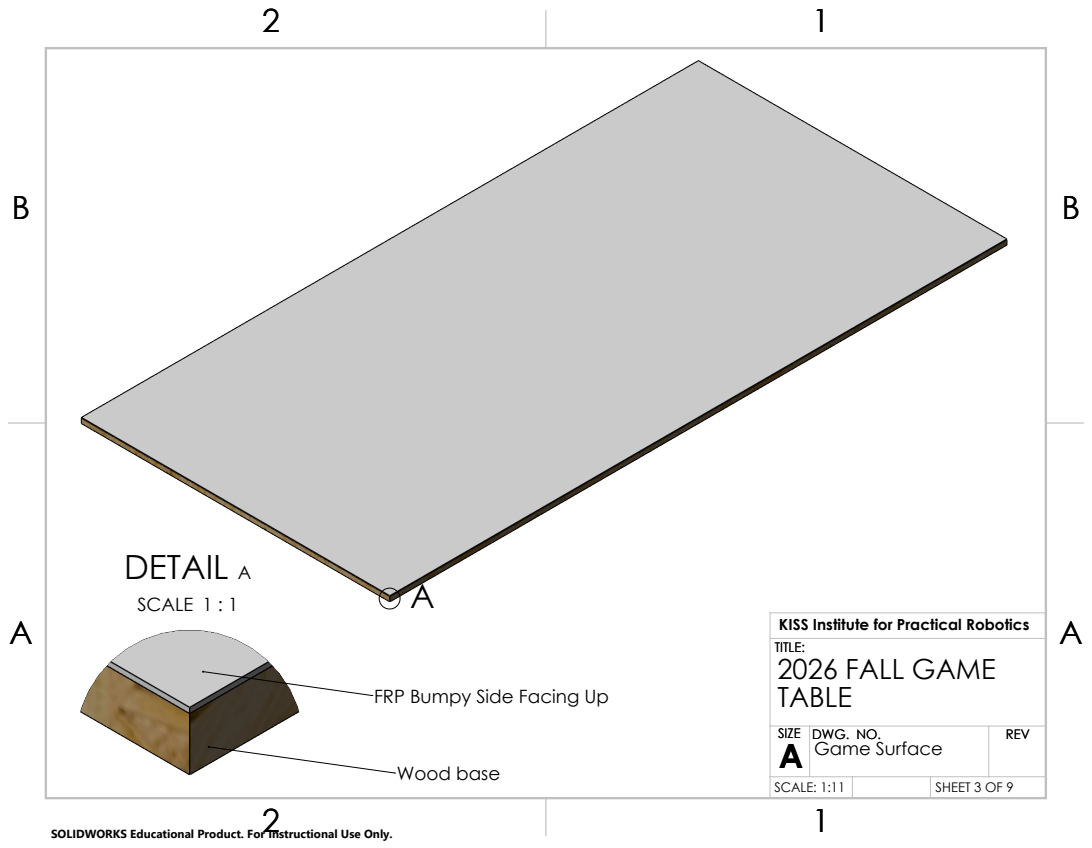
[picture p54: page 3]
DETAIL A; SCALE 1 : 1; Wood base; DWG. NO.

KISS Institute for Practical Robotics
TITLE:
2026 FALL GAME
TABLE
Game Surface

FRP Bumpy Side Facing Up

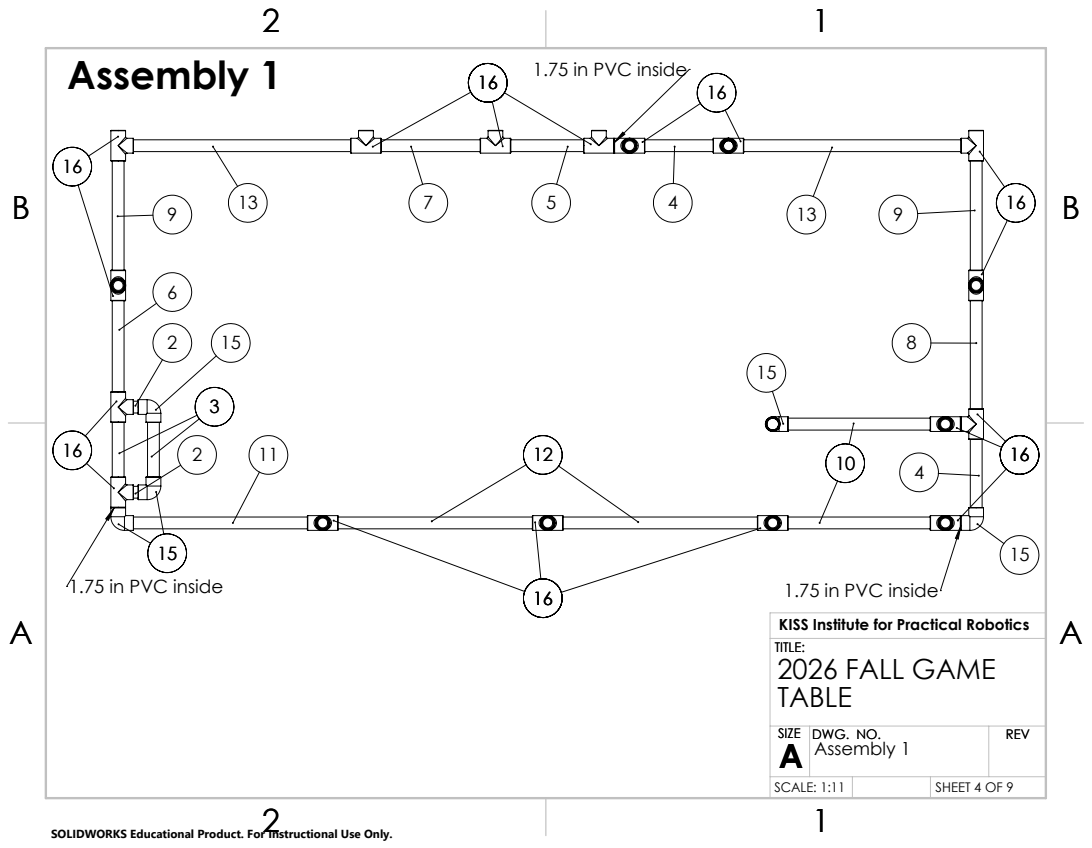
[picture p55: page 4]
1.75 in PVC inside; Assembly 1; DWG. NO.

1.75 in PVC inside

KISS Institute for Practical Robotics
TITLE:
2026 FALL GAME
TABLE
Assembly 1

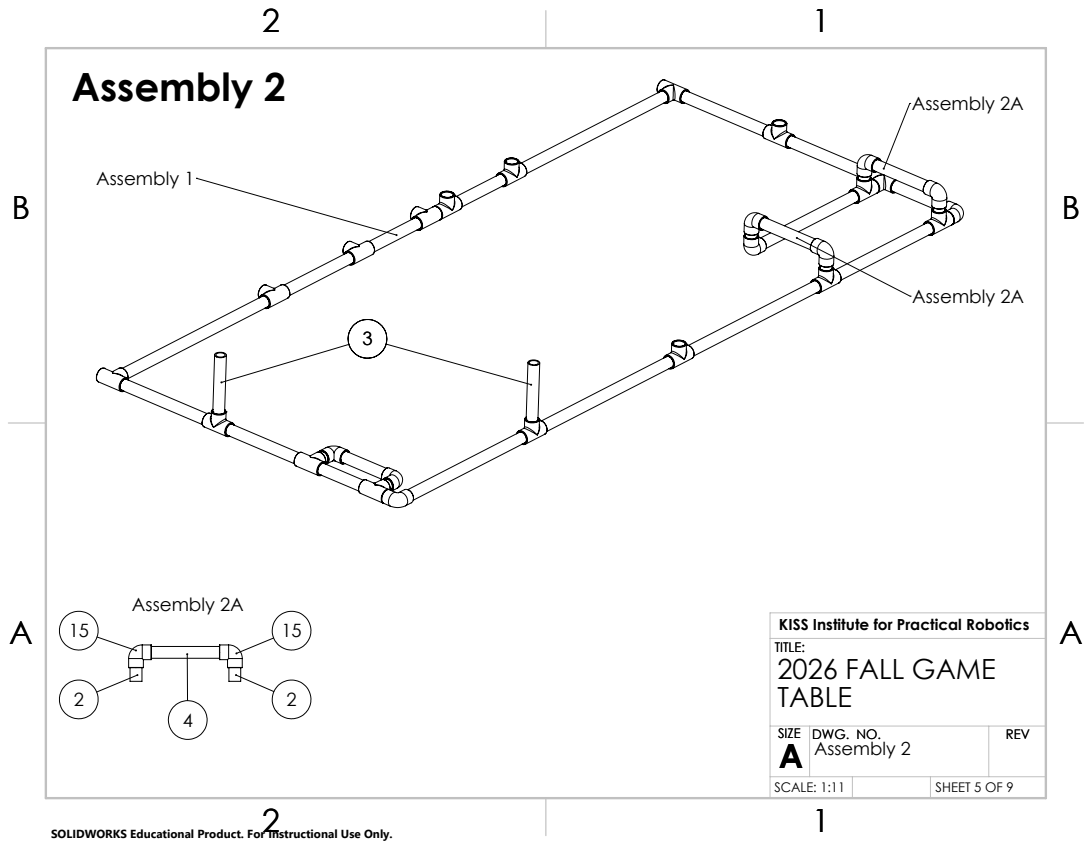
[picture p56: page 5]
Assembly 1; Assembly 2A; Assembly 2; DWG. NO.

KISS Institute for Practical Robotics
TITLE:
2026 FALL GAME
TABLE
Assembly 2

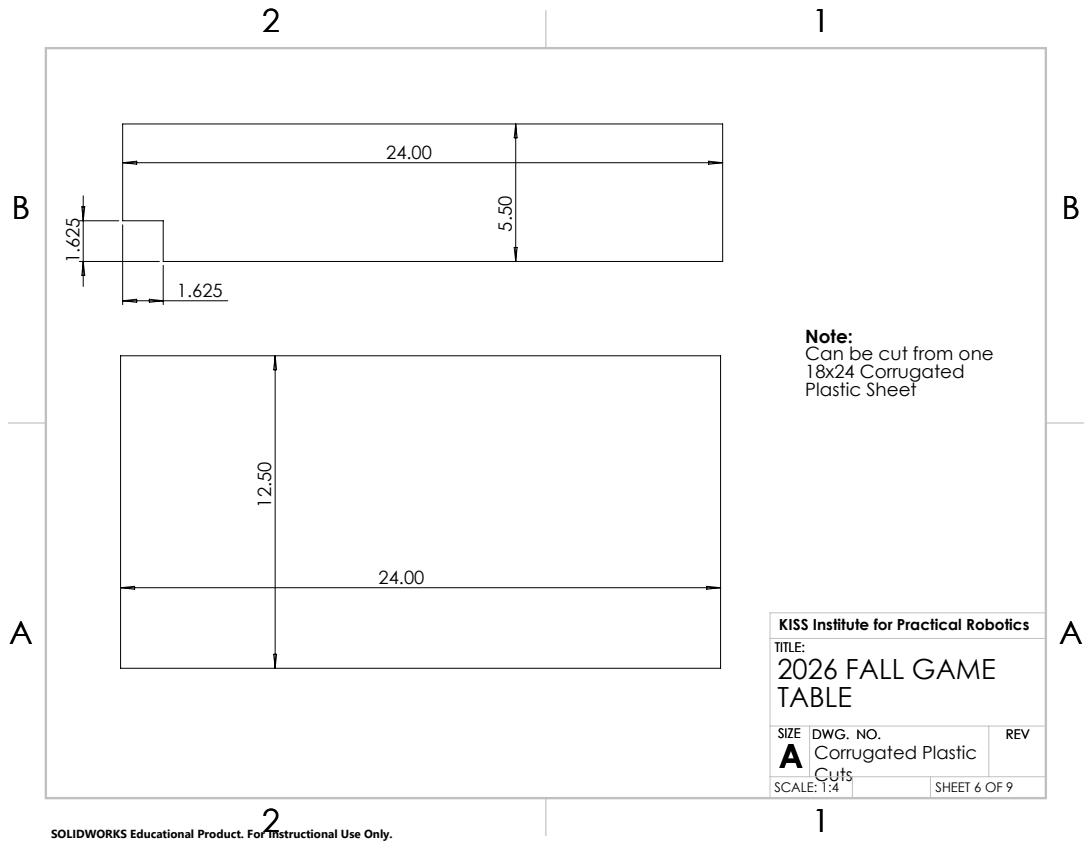
[picture p57: page 6]
DWG. NO.

Note:
Can be cut from one
18x24 Corrugated
Plastic Sheet

KISS Institute for Practical Robotics
TITLE:
2026 FALL GAME
TABLE
Corrugated Plastic
Cuts

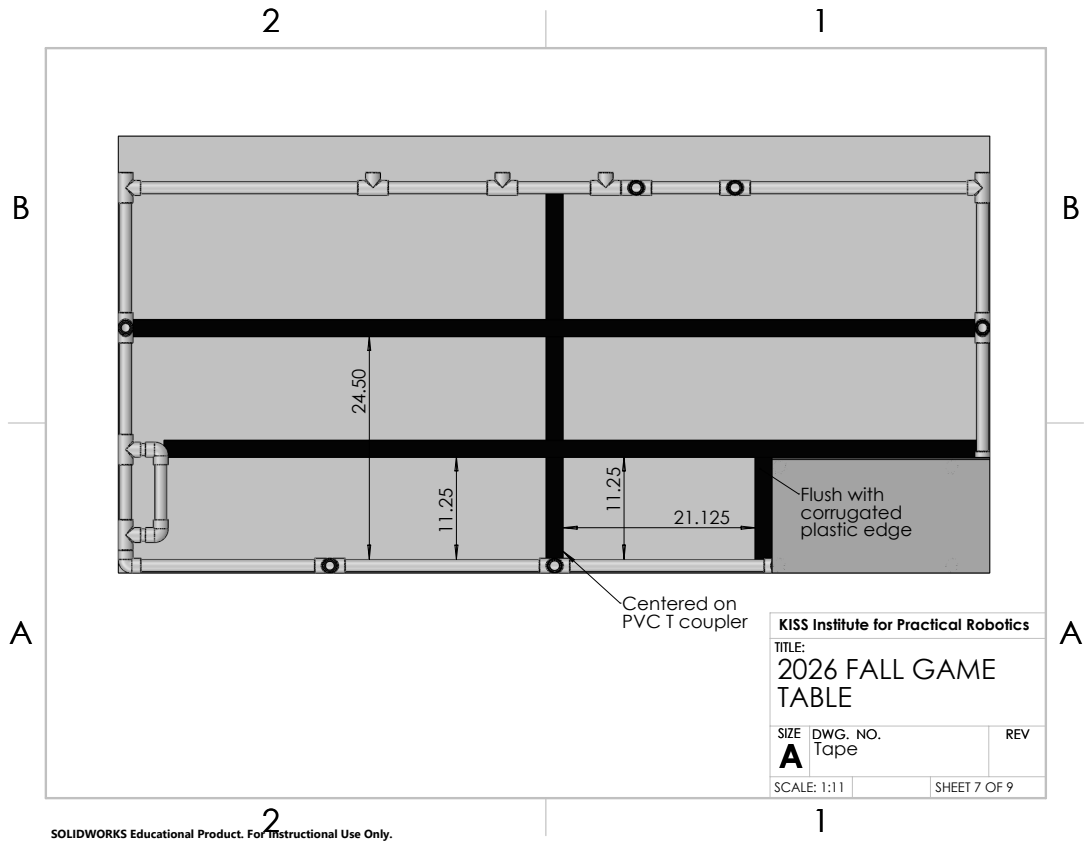
[picture p58: page 7]
Centered on PVC T coupler; Flush with plastic edge; DWG. NO.

KISS Institute for Practical Robotics
TITLE:
2026 FALL GAME
TABLE
Tape

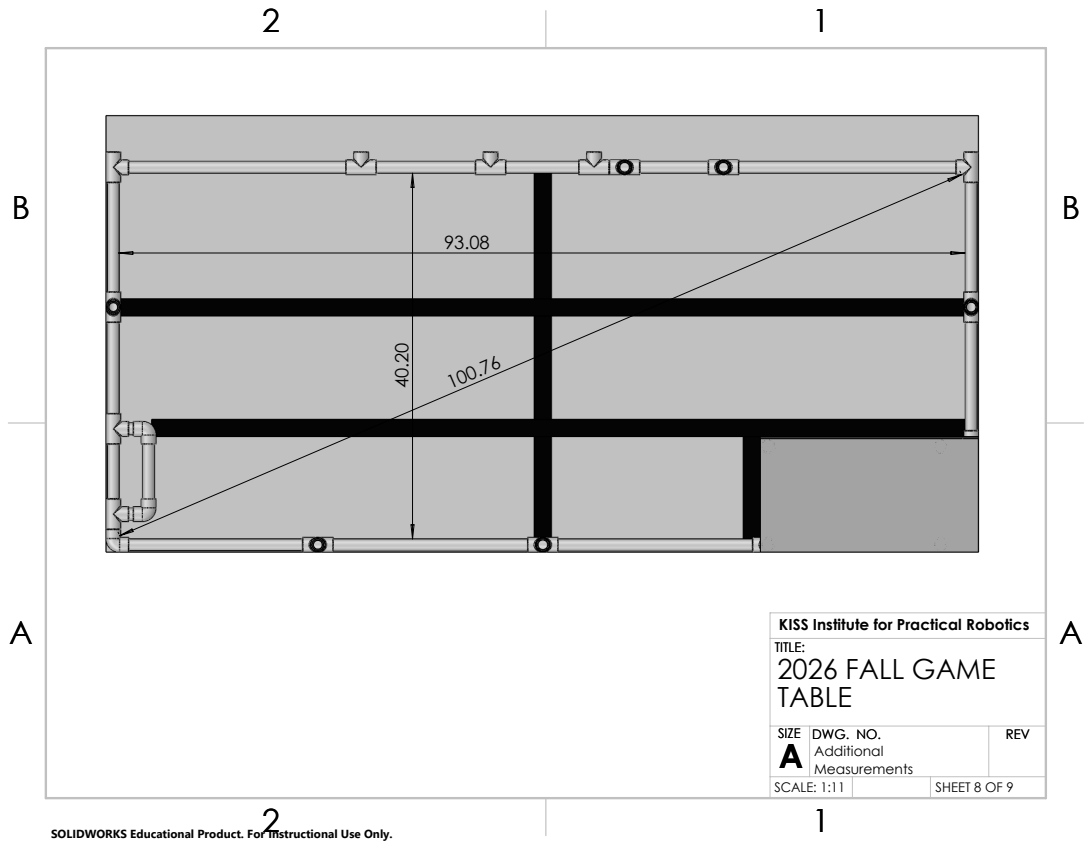
[picture p59: page 8]
DWG. NO.

KISS Institute for Practical Robotics
TITLE:
2026 FALL GAME
TABLE
Additional
Measurements

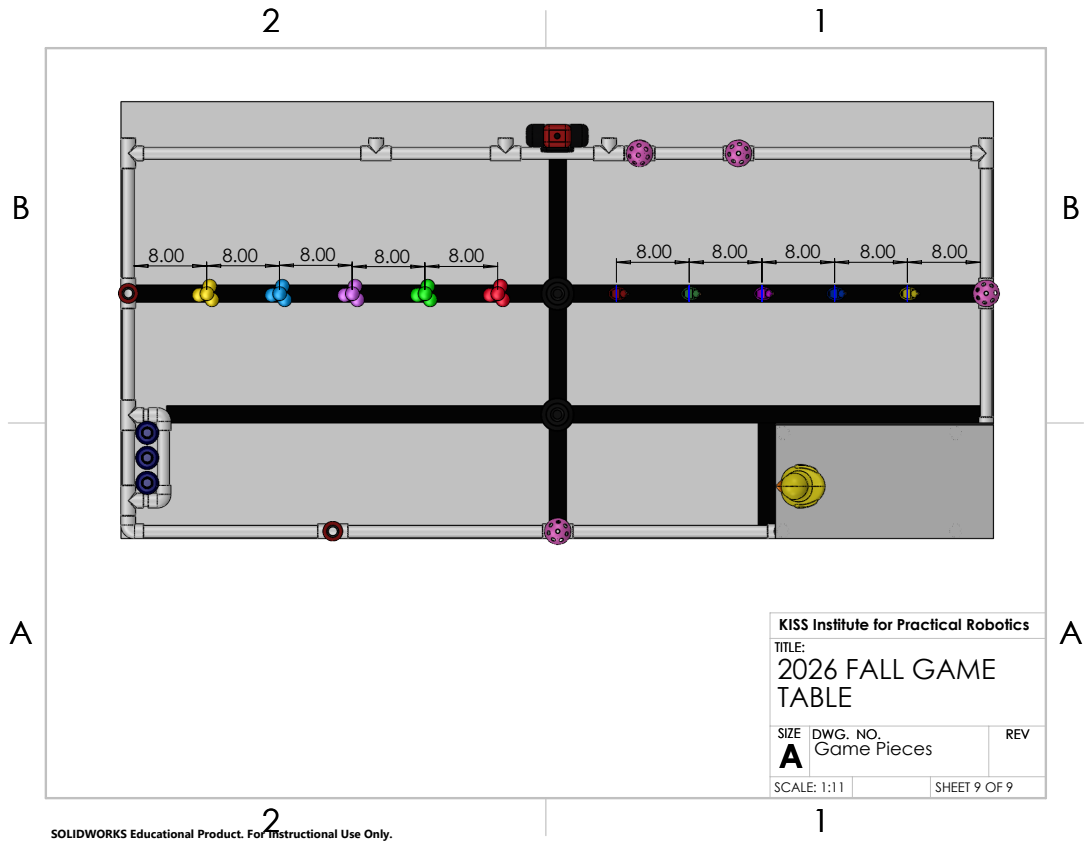
[picture p60: page 9]
DWG. NO.

KISS Institute for Practical Robotics
TITLE:
2026 FALL GAME
TABLE
Game Pieces
