Tigertay0/robotics/(commit log)

2026-10-21 Strategy v2 from the official rules, Blender model on the official table, kit docs
    - STRATEGY.md: rewritten against Botball_Fall_Game_Rule_Summary.pdf (zones incl. zone 5,
    per-group pom scoring, red pom under the lower cup, cup nesting, 120 s collision-checked
    timeline for both robots, failure plans, kit-only build notes)
    - blender/: build + animation scripts on Fall_Game_Table.glb and the KIPR part STLs,
    model .blend and stills; animation video and animated .blend follow in the next commit
    - docs/: rule summary and 2026 kit part lists; official GLB and STL parts for rebuilding
    [fall_game_2026.blend]
2026-10-21 Add the rendered strategy animation and the animated Blender scene
    [fall_game_2026_animated.blend]
2026-10-21 Corrected animation (pom stacks pushed into zone 1), first Wombat programs, last season's notes
    - blender: fix the pom-stack push timing, re-rendered video and animated scene
    - code/: robot_a and robot_b main.c with last season's calibration constants
    - docs/: Botball robotics 2025_26 notes (encoder, servo, sensor values)
    [fall_game_2026_animated.blend]
2026-10-21 Interactive assembly guide (3D, step by step) and 3D-print analysis
2026-10-21 Printed duck lane (two STLs within the mid-size limit), GitHub Pages front page
    [lane_front.stl, lane_rear.stl]
2026-10-21 Animation: moving flaps, hook, claw and arm; three close-up videos following the robots
    [fall_game_2026_animated.blend]
2026-11-10 auto: code review fixes 2026-10-31
    Automated nightly change. See the pull request for details.
    [animate_strategy.py, build_fall_game.py, main.c]
2026-11-10 feat: scoring calculator, field map, rules digest and Blender part generator
    - tools/score.py (+93 tests): exact scorer with switches for every ambiguous rule
    - data/field_map.json, tools/field_geom.py: every piece, zone and clearance in inches
    - docs/rules-digest.md: full rules digest and questions to send KIPR
    - docs/hardware.md, docs/prior-art.md: kit/Wombat specs and prior techniques
    - tools/blender: parametric part scripts + KIPR print-class/budget checker
    - docs/strategy-alt.md: alternative plan for comparison (STRATEGY.md stays the team plan)
    [Conduit Clamp.STL, Corner Cutter 1.5 in.STL, KIPR JIL Bot Chassis.STL, Nose Cone.STL, PVC Dispenser Manual.STL, PVC Dispenser.STL, Paddle.STL, camera_mount.stl]
2026-11-10 docs: robots guide (renders, every part and what it does, chassis note) and render script
2026-11-10 feat: printed mecanum chassis, 4-part print set, build manual, code animation
    - 3D prints follow the team rule (4 parts total, any size up to 220x220x250, print-in-place = 1):
    p1 Robot A chassis with built-in duck lane, p2 print-in-place geared claw,
    p3 pocket plow, p4 lipped cup hook; build_parts.py enforces the rule and checks
    watertightness, body count, clearance over the claw's swing and bed fit
    - docs/BUILD.md: step-by-step manual (order of work, table, both robots, wiring, code, tests, match day)
    - docs/animation: how both robots' code runs through a match
    - fix Robot B: pom-stack turn direction and the camera-scan unwind were inverted
    [p1_chassis_a.stl, p2_geared_claw.stl, p3_pocket_plow.stl, p4_cup_hook.stl]
2026-11-10 chore: delete the parts we won't print (4-part rule)
    Removes the 9-part alternative set (scripts + parts/out STLs) and the KIPR example
    STLs; only the 4 team prints in parts/team4 remain. build_parts.py drops --alt.
    [Conduit Clamp.STL, Corner Cutter 1.5 in.STL, KIPR JIL Bot Chassis.STL, Nose Cone.STL, PVC Dispenser Manual.STL, PVC Dispenser.STL, Paddle.STL, camera_mount.stl]
2026-11-10 feat: plan v3 collision-free routes, build manual v2, code on the new routes
    - tools/match_sim.py + match_plan.py + match_plot.py: 2D match simulator; plan v3 has
    0 contacts (robots never meet, Robot B never touches a duck); exports match_data.json
    - starts swapped (A in zone 5, B in the small box); both main.c follow v3 move for move
    with 4 timed hand-offs (wait_until_s)
    - build manual v2 (docs/manual): recognisable kit parts, name tags, KIT / 3D PRINTED
    badges, exact screw targets with arrows and zoom, claw page, video mode; kit-only BOM
    - data/kit_2026.json kit counts; STRATEGY timeline and score updated (625 core)
    - README rewritten as an index of everything; code/README, BUILD, RO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
    [p1_chassis_a.stl, p2_geared_claw.stl, p3_pocket_plow.stl, p4_cup_hook.stl]
2026-11-10 fix: mecanum rollers form an X, claw pivots from real geometry, piece paths follow the robots
    - build manual: roller handedness flips front/rear as well as left/right; claw finger pivots
    derived from the printed pin (were 2.3 mm off); manual viewer source saved in tools/
    - match_plan: carried ducks ride inside A's lane, pushed stack/cup ride on A's edge, red pom
    rides with B's claw; time_when raises instead of returning the window end
    - match_data.json re-exported
    [export_build_manual.py]
2026-11-10 fix: manual fasteners on real holes (servo ears, gates, sensors), mecanum shaft reaches the hub; fastener checker
    [export_build_manual.py]
2026-11-10 feat: chassis for the measured 60x60x53 mm ducks, wheel holes 7 mm lower and moved inward; OBJ exports; size check
    [p1_chassis_a.obj, p1_chassis_a.stl, p2_geared_claw.obj, p3_pocket_plow.obj, p4_cup_hook.obj, robot_a.obj, robot_b.obj]
2026-11-10 feat: one-piece claw jaw, lane sized for 5 real ducks, corrected duck drop positions
    - print 2 is now p2_claw_jaw: one solid piece (base + fixed finger + pom pad); the moving
    finger is a kit 1x7 liftarm on a Round Servo Horn. The 3-body geared claw is removed.
    - print 1: pin-gate slot one duck (+ flap) in front of the exit slot
    - manual: intake plates at full length, gate C on a bent-strap bridge, tophats outside the
    plates, gate brackets on real deck holes, size check of both robots, OBJ of both robots
    - plan + robot A code: a dropped duck stays 2.48 in behind the centre, creep 3.3 in,
    Zone 1 drop moved west (was on tape), lane switch no longer stops the duck run
    - docs updated (3D_PR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
    [p2_claw_jaw.obj, p2_claw_jaw.stl, p2_geared_claw.obj, p2_geared_claw.stl, robot_b.obj]
2026-11-10 auto: code review fixes 2026-11-05
    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
    [export_build_manual.py, main.c]
2026-11-10 docs: reconcile with the restored main (earlier printed lane marked superseded, front page links to the current manual and parts)
2026-11-10 feat: kit parts drawn after the pictures in the 2026 kit lists; full LEGO list in the kit data
    - Black Gear Motor as the servo-shaped black box it is; tophat, light, touch and ET sensors as
    black boards; black standoffs; black/yellow battery; Round Servo Horn with 6 holes
    - data/kit_2026.json now holds every line of the three kit lists (156 entries)
    - manual, models (GLB/OBJ) and BOM regenerated
    [robot_a.obj, robot_b.obj]
2026-11-10 fix: duck lane sequence (longer duck run, settle move before drops 2-5), liftarm card picture
    - match_plan + robot A code: follow the tape 39.1 in so the 5th duck is behind intake gate C,
    then shut C and back 2.5 in; settle_ducks() rolls 2.4 in forward before every drop but the
    first, so the next duck is at the exit gate; held ducks keep their lane place during a creep
    - the plan asserts that each duck is at the exit gate when its drop starts
    - manual viewer: a part drawn only as a tagged sub-mesh gets its card picture
    - match_data.json re-exported; docs updated
    [main.c]
2026-11-10 feat: 'How our robots think' rebuilt for the current robots, kit part names and duck sequence
2026-11-10 feat: build manual video re-rendered from the current manual (new chassis, one-piece claw, kit-accurate parts)
